NiceCircuits/DrOctopus/design/mechanical/sketches/_MG_1017.JPG

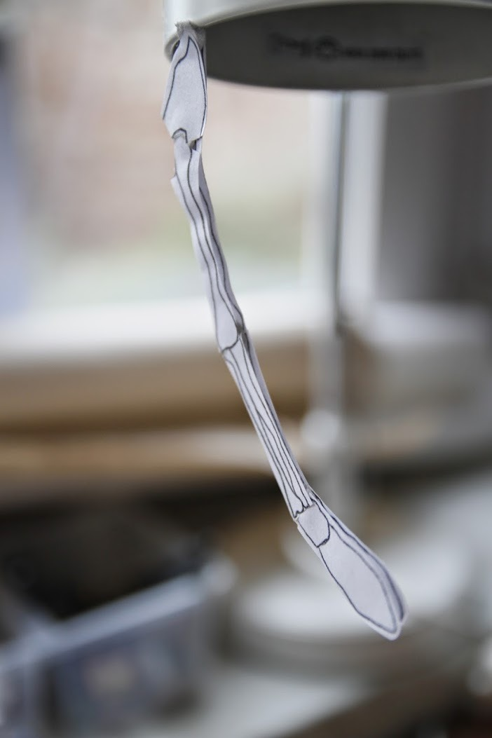
design/mechanical/sketches/_MG_1017.JPG
