NiceCircuits/DrOctopus/design/mechanical/sketches/_MG_1016.JPG

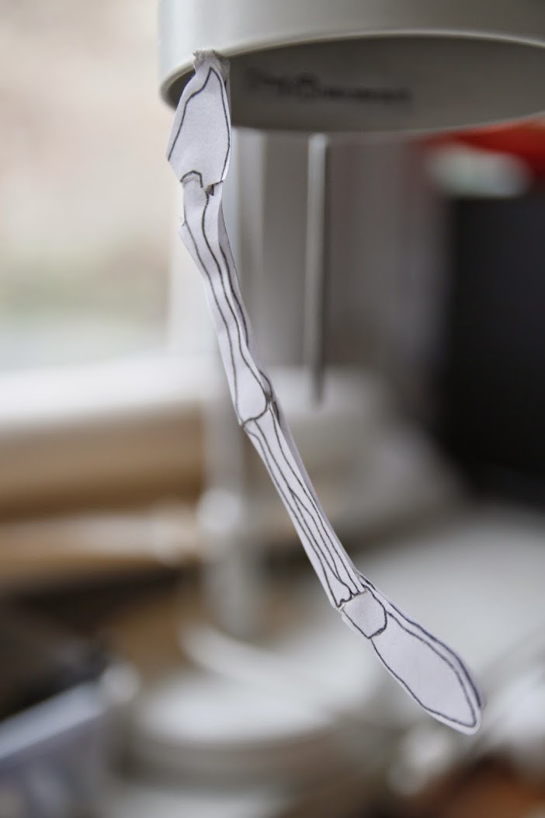
design/mechanical/sketches/_MG_1016.JPG
