NiceCircuits/DrOctopus/design/calculations.xls

Sheet: uC pinout
HW0 - STM32F303RE |  |  |  |  |  |  |  |  |  | HW1 - STM32F030RCT |  |  |  |  |  |  |  |  |  | HW1 - STM32F103RE - discarded
pin | pin type | main function | ADC | PWM1 | PWM2 | UART | I2C | Other | Function | pin | pin type | main function | ADC | PWM1 | PWM2 | UART | I2C | Other | Function | pin | pin type | main function | ADC | PWM1 | PWM2 | UART | I2C | Other | Function
1 | pwrIn | VBAT |  |  |  |  |  |  | - | 1 | pwrIn | VDD |  |  |  |  |  |  | - | 1 | pwrIn | VBAT |  |  |  |  |  |  | -
2 | IO | PC13-TAMPER-RTC |  |  | TIM1_CH1N |  |  |  | N.C. | 2 | IO | PC13-TAMPER-RTC |  |  |  |  |  |  | N.C. | 2 | IO | PC13-TAMPER-RTC |  |  |  |  |  |  | N.C.
3 | IO | PC14-OSC32_IN |  |  |  |  |  |  | N.C. | 3 | IO | PC14-OSC32_IN |  |  |  |  |  |  | N.C. | 3 | IO | PC14-OSC32_IN |  |  |  |  |  |  | N.C.
4 | IO | PC15-OSC32_OUT |  |  |  |  |  |  | N.C. | 4 | IO | PC15-OSC32_OUT |  |  |  |  |  |  | N.C. | 4 | IO | PC15-OSC32_OUT |  |  |  |  |  |  | N.C.
5 | IO | OSC_IN |  |  | TIM1_CH3N |  | I2C2_SDA | PF0 | - | 5 | input | OSC_IN |  |  |  |  |  |  | - | 5 | input | OSC_IN |  |  |  |  |  |  | -
6 | IO | OSC_OUT |  |  |  |  | I2C2_SCL | PF1 | - | 6 | output | OSC_OUT |  |  |  |  |  |  | - | 6 | output | OSC_OUT |  |  |  |  |  |  | -
7 | IO | NRST |  |  |  |  |  |  | - | 7 | IO | NRST |  |  |  |  |  |  | - | 7 | IO | NRST |  |  |  |  |  |  | -
8 | IO | PC0 | ADC12_IN6 | TIM1_CH1 |  |  |  |  | heater_sig | 8 | IO | PC0 | ADC_IN10 |  |  | USART6_TX USART7_TX |  |  | N.C. | 8 | IO | PC0 | ADC12_IN10 |  |  |  |  |  | N.C.
9 | IO | PC1 | ADC12_IN7 | TIM1_CH2 |  |  |  |  | therm3_sig | 9 | IO | PC1 | ADC_IN11 |  |  | USART6_RX USART7_RX |  |  | therm3_sig | 9 | IO | PC1 | ADC12_IN11 |  |  |  |  |  | therm3_sig
10 | IO | PC2 | ADC12_IN8 | TIM1_CH3 |  |  |  |  | therm4_sig | 10 | IO | PC2 | ADC_IN12 |  |  |  |  |  | therm4_sig | 10 | IO | PC2 | ADC12_IN12 |  |  |  |  |  | therm4_sig
11 | IO | PC3 | ADC12_IN9 | TIM1_CH4 |  |  |  |  | therm1_sig | 11 | IO | PC3 | ADC_IN13 |  |  |  |  |  | therm5_sig | 11 | IO | PC3 | ADC12_IN13 |  |  |  |  |  | therm5_sig
12 | pwrIn | VSSA |  |  |  |  |  |  | - | 12 | pwrIn | VSSA |  |  |  |  |  |  | - | 12 | pwrIn | VSSA |  |  |  |  |  |  | -
13 | pwrIn | VDDA |  |  |  |  |  |  | - | 13 | pwrIn | VDDA |  |  |  |  |  |  | - | 13 | pwrIn | VDDA |  |  |  |  |  |  | -
14 | IO | PA0/WKUP | ADC1_IN1 | TIM2_CH1 |  |  |  |  | therm2_sig | 14 | IO | PA0/WKUP | ADC_IN0 |  |  | USART4_TX |  |  | N.C. | 14 | IO | PA0/WKUP | ADC12_IN0 | TIM2_CH1 |  |  |  |  | N.C.
15 | IO | PA1 | ADC1_IN2 | TIM2_CH2 | TIM15_CH1N |  |  |  | bts_fb_sig | 15 | IO | PA1 | ADC_IN1 |  |  | USART4_RX |  |  | N.C. | 15 | IO | PA1 | ADC12_IN1 | TIM2_CH2 |  |  |  |  | N.C.
16 | IO | PA2 | ADC1_IN3 | TIM2_CH3 | TIM15_CH1 | USART2_TX |  |  | DBG_TxD | 16 | IO | PA2 | ADC_IN2 | TIM15_CH1 |  | USART2_TX |  |  | DBG_TxD | 16 | IO | PA2 | ADC12_IN2 | TIM2_CH3 |  | USART2_TX |  |  | DBG_TxD
17 | IO | PA3 | ADC1_IN4 | TIM2_CH4 | TIM15_CH2 | USART2_RX |  |  | DBG_RxD | 17 | IO | PA3 | ADC_IN3 | TIM15_CH2 |  | USART2_RX |  |  | DBG_RxD | 17 | IO | PA3 | ADC12_IN3 | TIM2_CH4 |  | USART2_RX |  |  | DBG_RxD
18 | pwrIn | VSS |  |  |  |  |  |  | - | 18 | pwrIn | VSS |  |  |  |  |  |  | - | 18 | pwrIn | VSS |  |  |  |  |  |  | -
19 | pwrIn | VDD |  |  |  |  |  |  | - | 19 | pwrIn | VDD |  |  |  |  |  |  | - | 19 | pwrIn | VDD |  |  |  |  |  |  | -
20 | IO | PA4 | ADC2_IN1 | TIM3_CH2 |  |  |  |  |  | 20 | IO | PA4 | ADC_IN4 | TIM14_CH1 |  | USART6_TX |  |  | B2B_therm6_sig | 20 | IO | PA4 | ADC12_IN4 |  |  |  |  |  | B2B_therm6_sig
21 | IO | PA5 | ADC2_IN2 | TIM2_CH1 |  |  |  |  | led1_cmd | 21 | IO | PA5 | ADC_IN5 |  |  | USART6_RX |  |  | heater_sig | 21 | IO | PA5 | ADC12_IN5 |  |  |  |  |  | heater_sig
22 | IO | PA6 | ADC2_IN3 | TIM3_CH1 | TIM16_CH1 |  |  |  |  | 22 | IO | PA6 | ADC_IN6 | TIM3_CH1 | TIM16_CH1 |  |  |  | therm0_sig | 22 | IO | PA6 | ADC12_IN6 | TIM3_CH1 |  |  |  |  | therm0_sig
23 | IO | PA7 | ADC2_IN4 | TIM3_CH2 | TIM1_CH1N,... |  |  |  |  | 23 | IO | PA7 | ADC_IN7 | TIM3_CH2 | TIM1_CH1N TIM14_CH1 TIM17_CH1 |  |  |  | therm1_sig | 23 | IO | PA7 | ADC12_IN7 | TIM3_CH2 | TIM1_CH1N |  |  |  | therm1_sig
24 | IO | PC4 | ADC2_IN5 |  |  | USART1_TX |  |  |  | 24 | IO | PC4 | ADC_IN14 |  |  | USART3_TX |  |  | therm2_sig | 24 | IO | PC4 | ADC12_IN14 |  |  |  |  |  | therm2_sig
25 | IO | PC5 | ADC2_IN11 |  |  | USART1_RX |  |  |  | 25 | IO | PC5 | ADC_IN15 |  |  | USART3_RX |  |  | bts_fb_sig | 25 | IO | PC5 | ADC12_IN15 |  |  |  |  |  | bts_fb_sig
26 | IO | PB0 | ADC3_IN12 | TIM3_CH3 | TIM1_CH2N,... |  |  |  | B2B_esp_boot | 26 | IO | PB0 | ADC_IN8 | TIM3_CH3 | TIM1_CH2N |  |  |  | B2B_esp_boot | 26 | IO | PB0 | ADC12_IN8 | TIM3_CH3 | TIM1_CH2N |  |  |  | B2B_esp_boot
27 | IO | PB1 | ADC3_IN1 | TIM3_CH4 | TIM1_CH3N,... |  |  |  | B2B_esp_en | 27 | IO | PB1 | ADC_IN9 | TIM3_CH4 | TIM1_CH3N TIM14_CH1 |  |  |  | B2B_esp_en | 27 | IO | PB1 | ADC12_IN9 | TIM3_CH4 | TIM1_CH3N |  |  |  | B2B_esp_en
28 | IO | PB2 | ADC2_IN12 |  |  |  |  |  | N.C. | 28 | IO | PB2 |  |  |  |  |  |  | N.C. | 28 | IO | PB2 |  |  |  |  |  |  | N.C.
29 | IO | PB10 |  | TIM2_CH3 |  | USART3_TX |  |  |  | 29 | IO | PB10 |  |  |  | USART3_TX | I2C2_SCL |  | scl | 29 | IO | PB10 |  | TIM2_CH3 |  | USART3_TX | I2C2_SCL |  | scl
30 | IO | PB11 | ADC12_IN14 | TIM2_CH4 |  | USART3_RX |  |  | therm0_sig | 30 | IO | PB11 |  |  |  | USART3_RX | I2C2_SDA |  | sda | 30 | IO | PB11 |  | TIM2_CH4 |  | USART3_RX | I2C2_SDA |  | sda
31 | pwrIn | VSS |  |  |  |  |  |  | - | 31 | pwrIn | VSS |  |  |  |  |  |  | - | 31 | pwrIn | VSS |  |  |  |  |  |  | -
32 | pwrIn | VDD |  |  |  |  |  |  | - | 32 | pwrIn | VDD |  |  |  |  |  |  | - | 32 | pwrIn | VDD |  |  |  |  |  |  | -
33 | IO | PB12 | ADC4_IN3 |  |  |  |  |  |  | 33 | IO | PB12 |  |  |  |  |  |  | led1_cmd | 33 | IO | PB12 |  |  |  |  |  |  | led1_cmd
34 | IO | PB13 | ADC3_IN5 |  | TIM1_CH1N |  |  |  | led2_cmd | 34 | IO | PB13 |  |  | TIM1_CH1N |  | I2C2_SDA |  | led2_cmd | 34 | IO | PB13 |  |  | TIM1_CH1N |  |  |  | led2_cmd
35 | IO | PB14 | ADC4_IN4 | TIM15_CH1 | TIM1_CH2N |  |  |  | led3_cmd | 35 | IO | PB14 |  | TIM15_CH1 | TIM1_CH2N |  | I2C2_SDA |  | servo6_cmd - alternative | 35 | IO | PB14 |  |  | TIM1_CH2N |  |  |  | N.C.
36 | IO | PB15 | ADC4_IN5 | TIM15_CH2 | TIM1_CH3N |  |  |  | N.C. | 36 | IO | PB15 |  | TIM15_CH2 | TIM1_CH3N |  |  |  | servo5_cmd - alternative | 36 | IO | PB15 |  |  | TIM1_CH3N |  |  |  | N.C.
37 | IO | PC6 |  | TIM3_CH1 | TIM8_CH1 |  |  |  | heater_cmd | 37 | IO | PC6 |  | TIM3_CH1 |  |  |  |  | heater_cmd | 37 | IO | PC6 |  | TIM3_CH1 |  |  |  |  | heater_cmd
38 | IO | PC7 |  | TIM3_CH2 | TIM8_CH2 |  |  |  | fan1_cmd | 38 | IO | PC7 |  | TIM3_CH2 |  |  |  |  | fan1_cmd | 38 | IO | PC7 |  | TIM3_CH2 |  |  |  |  | fan1_cmd
39 | IO | PC8 |  | TIM3_CH3 | TIM8_CH3 |  |  |  | fan2_cmd | 39 | IO | PC8 |  | TIM3_CH3 |  |  |  |  | fan2_cmd | 39 | IO | PC8 |  | TIM3_CH3 |  |  |  |  | fan2_cmd
40 | IO | PC9 |  | TIM3_CH4 | TIM8_CH4 |  | I2C3_SDA |  | motor_cmd | 40 | IO | PC9 |  | TIM3_CH4 |  |  |  |  | motor_cmd | 40 | IO | PC9 |  | TIM3_CH4 |  |  |  |  | motor_cmd
41 | IO | PA8 |  | TIM1_CH1 |  |  | I2C3_SCL |  | servo0_cmd | 41 | IO | PA8 |  | TIM1_CH1 |  |  |  |  | servo0_cmd | 41 | IO | PA8 |  | TIM1_CH1 |  |  |  |  | servo0_cmd
42 | IO | PA9 |  | TIM1_CH2 | TIM2_CH3 | USART1_TX | I2C2_SCL |  | servo1_cmd | 42 | IO | PA9 |  | TIM1_CH2 |  | USART1_TX | I2C1_SCL |  | servo1_cmd | 42 | IO | PA9 |  | TIM1_CH2 |  | USART1_TX |  |  | servo1_cmd
43 | IO | PA10 |  | TIM1_CH3 | TIM2_CH4 | USART1_RX | I2C2_SDA |  | servo2_cmd | 43 | IO | PA10 |  | TIM1_CH3 |  | USART1_RX | I2C1_SDA |  | servo2_cmd | 43 | IO | PA10 |  | TIM1_CH3 |  | USART1_RX |  |  | servo2_cmd
44 | IO | PA11 |  | TIM1_CH4 | TIM4_CH1 |  |  | USBDM | servo3_cmd | 44 | IO | PA11 |  | TIM1_CH4 |  |  | I2C2_SCL |  | servo3_cmd | 44 | IO | PA11 |  | TIM1_CH4 |  |  |  | USBDM | servo3_cmd
45 | IO | PA12 |  | TIM16_CH1 | TIM4_CH2 |  |  | USBDP | servo5_cmd | 45 | IO | PA12 |  |  |  |  | I2C2_SDA |  | N.C. | 45 | IO | PA12 |  |  |  |  |  | USBDP | N.C.
46 | IO | PA13/TMS |  | TIM16_CH1N | TIM4_CH3 |  |  | TMS | servo4_cmd | 46 | IO | PA13/TMS |  |  |  |  |  | TMS | SWDIO | 46 | IO | PA13/TMS |  |  |  |  |  | TMS | SWDIO
47 | pwrIn | VSS |  |  |  |  |  |  | - | 47 | pwrIn | VSS |  |  |  |  |  |  | - | 47 | pwrIn | VSS |  |  |  |  |  |  | -
48 | pwrIn | VDD |  |  |  |  |  |  | - | 48 | pwrIn | VDD |  |  |  |  |  |  | - | 48 | pwrIn | VDD |  |  |  |  |  |  | -
49 | IO | PA14/TCK |  |  | TIM8_CH1 | USART2_TX | I2C1_SDA | TCK | SWCLK | 49 | IO | PA14/TCK |  |  |  | USART2_TX |  | TCK | SWCLK | 49 | IO | PA14/TCK |  |  |  |  |  | TCK | WCLK
50 | IO | PA15 |  | TIM2_CH1 | TIM8_CH2 | USART2_RX | I2C1_SCL |  | button0_sig | 50 | IO | PA15 |  |  |  | USART2_RX |  |  | button0_sig | 50 | IO | PA15 |  | TIM2_CH1 |  |  |  |  | button0_sig
51 | IO | PC10 |  |  | TIM8_CH1N | USART3_TX |  |  | B2B_ESP_TxD | 51 | IO | PC10 |  |  |  | USART3_TX USART4_TX |  |  | B2B_ESP_TxD | 51 | IO | PC10 |  |  |  | USART3_TX |  |  | B2B_ESP_TxD
52 | IO | PC11 |  |  | TIM8_CH2N | USART3_RX |  |  | B2B_ESP_RxD | 52 | IO | PC11 |  |  |  | USART3_RX USART4_RX |  |  | B2B_ESP_RxD | 52 | IO | PC11 |  |  |  | USART3_RX |  |  | B2B_ESP_RxD
53 | IO | PC12 |  |  | TIM8_CH3N | UART5_TX |  |  | button1_sig | 53 | IO | PC12 |  |  |  | USART5_TX |  |  | button1_sig | 53 | IO | PC12 |  |  |  |  |  |  | button1_sig
54 | IO | PD2 |  |  |  |  | UART5_RX |  | N.C. | 54 | IO | PD2 |  |  |  | USART5_RX |  |  | N.C. | 54 | IO | PD2 |  |  |  |  |  |  | N.C.
55 | IO | PB3/SWO |  | TIM2_CH2 | TIM8_CH1N | USART2_TX |  | SWO | SWO | 55 | IO | PB3/SWO |  |  |  | USART5_TX |  |  | SWO not available | 55 | IO | PB3/SWO |  | TIM2_CH2 |  |  |  | SWO | SWO
56 | IO | PB4 |  | TIM3_CH1 | TIM8_CH2N | USART2_RX |  |  | N.C. | 56 | IO | PB4 |  | TIM3_CH1 |  | USART5_RX |  |  | N.C. | 56 | IO | PB4 |  | TIM3_CH1 |  |  |  |  | N.C.
57 | IO | PB5 |  | TIM3_CH2 | TIM8_CH3N |  | I2C3_SDA |  | N.C. | 57 | IO | PB5 |  | TIM3_CH2 |  |  |  |  | N.C. | 57 | IO | PB5 |  | TIM3_CH2 |  |  |  |  | N.C.
58 | IO | PB6 |  | TIM4_CH1 | TIM8_CH1 | USART1_TX | I2C1_SCL |  | servo6_cmd | 58 | IO | PB6 |  | TIM16_CH1N |  | USART1_TX | I2C1_SCL |  | servo6_cmd - no pwm! | 58 | IO | PB6 |  | TIM4_CH1 |  | USART1_TX | I2C1_SCL |  | servo6_cmd
59 | IO | PB7 |  | TIM4_CH2 | TIM3_CH4 | USART1_RX | I2C1_SDA |  | sda | 59 | IO | PB7 |  | TIM17_CH1N |  | USART1_RX | I2C1_SDA |  | servo5_cmd - no pwm! | 59 | IO | PB7 |  | TIM4_CH2 |  | USART1_RX | I2C1_SDA |  | servo5_cmd
60 | input | BOOT0 |  |  |  |  |  |  | - | 60 | input | BOOT0 |  |  |  |  |  |  | - | 60 | input | BOOT0 |  |  |  |  |  |  | -
61 | IO | PB8 |  | TIM4_CH3 | TIM8_CH2 | USART3_RX | I2C1_SCL |  | scl | 61 | IO | PB8 |  | TIM16_CH1 |  |  | I2C1_SCL |  | servo4_cmd | 61 | IO | PB8 |  | TIM4_CH3 |  |  | I2C1_SCL |  | servo4_cmd
62 | IO | PB9 |  | TIM4_CH4 | TIM8_CH3 | USART3_TX | I2C1_SDA |  | servo7_cmd | 62 | IO | PB9 |  | TIM17_CH1 |  |  | I2C1_SDA |  | servo7_cmd | 62 | IO | PB9 |  | TIM4_CH4 |  |  | I2C1_SDA |  | servo7_cmd
63 | pwrIn | VSS |  |  |  |  |  |  | - | 63 | pwrIn | VSS |  |  |  |  |  |  | - | 63 | pwrIn | VSS |  |  |  |  |  |  | -
64 | pwrIn | VDD |  |  |  |  |  |  | - | 64 | pwrIn | VDD |  |  |  |  |  |  | - | 64 | pwrIn | VDD |  |  |  |  |  |  | -
 |  | needed | 9 | 4..12 |  | 4 | 2 |  | N.C.
 |  |  |  |  |  |  |  |  | N.C.
 |  |  |  |  |  |  |  |  | N.C.
 |  |  |  |  |  |  |  |  | B2B_therm6_sig
 |  |  |  |  |  |  |  |  | therm5_sig

Sheet: uC peripherals
HW0 - STM32F303RE
Timers
Timer | Used as
TIM1 | Servos
TIM2 | Delay
TIM3 | PWM
TIM4 | Servos
TIM6
TIM7
TIM8
TIM15
TIM16
TIM17
TIM20
UARTs
USART1
USART2 | Debug
USART3 | ESP8266
UART4
UART5
