NiceCircuits/DrOctopus/design/mechanical/design.xls

DrOctopus arm design
Motors |  |  |  | g [m/s2] | 10
 | mass [kg] | max. acceleration [deg/s2]
M0 | 0.1 | 50
M1 | 0.2 | 50
M2 | 0.1 | 50
M3 | 0.05 | 50
arm segments
 | mass [kg] | length [m]
l1 | 0.3 | 0.3
l2 | 0.3 | 0.24
l3 | 0.1 | 0.1
mass of actuator [kg]
A | 0.3
Absolute maximum moments on joints (motors)
 | static [N*m] | dynamic [N*m] | static+dynamic
 |  |  | [N*m] | [kg*cm]
M0 | 0 | 0.31 | 0.31 | 3.1
M1 | 3.45 | 0.31 | 3.76 | 37.6
M2 | 1.2 | 0.13 | 1.33 | 13.3
M3 | 0 | 0.03 | 0.03 | 0.3
Real values
a,b max=90*
a,b min=0*
 | static [N*m] | dynamic [N*m] | static+dynamic
 |  |  | [N*m] | [kg*cm]
M0 | 0 | 0.31 | 0.31 | 3.1
M1 | 2.7 | 0.31 | 3.01 | 30.1
M2 | 1.2 | 0.13 | 1.33 | 13.3
M3 | 0 | 0.03 | 0.03 | 0.3
