NiceCircuits/DrOctopus/3D model/plywood_6mm.pdf

P

R

O
D

U

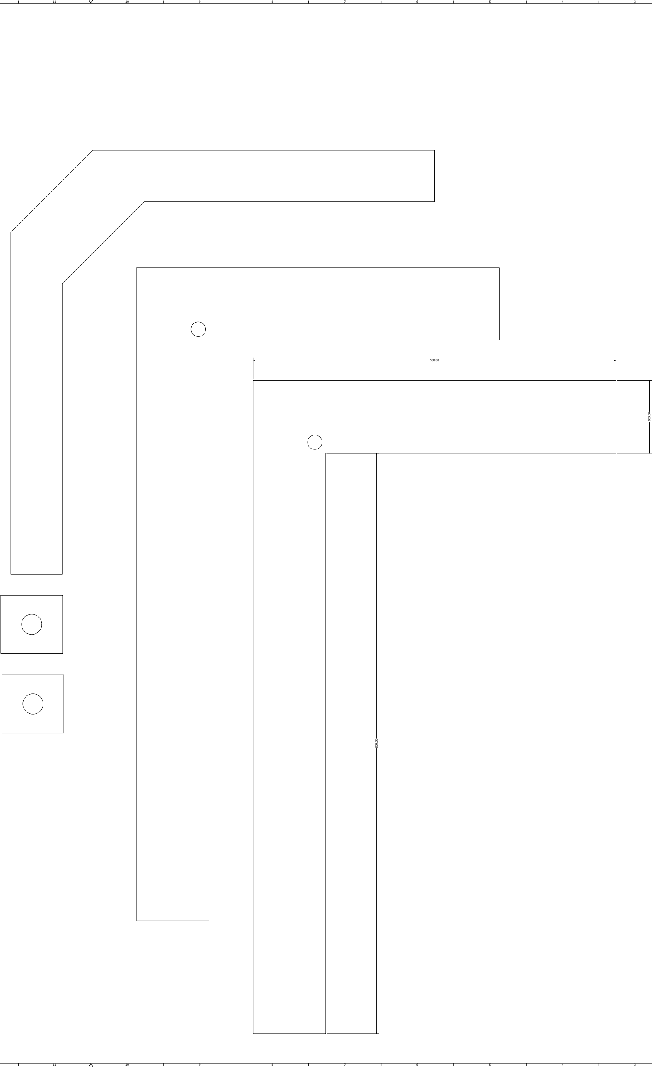
[picture p3: figure]

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
# TIO

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
# TIO

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
# PRODUCED BY AN AUTODESK EDUCATIONAL PRODUCT

# PRODUCED BY AN AUTODESK EDUCATIONAL PRODUCT

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
## ply

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
600.00
