NiceCircuits/DrOctopus/3D model/full_instalation.jpg

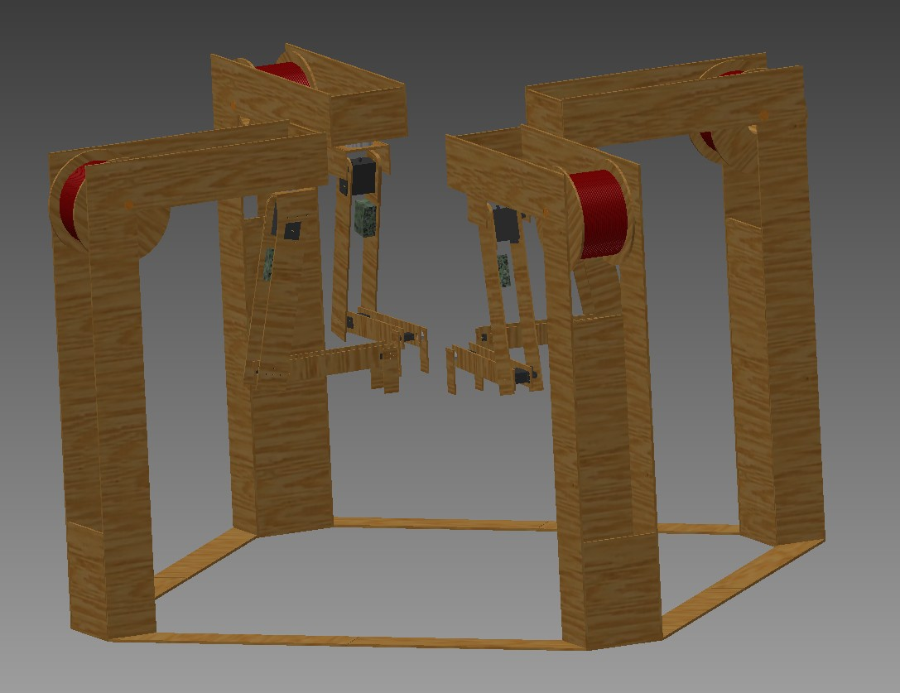
3D model/full_instalation.jpg
