NiceCircuits/DrOctopus/design/mechanical/sketches/2014-07-31 18.15.07.jpg

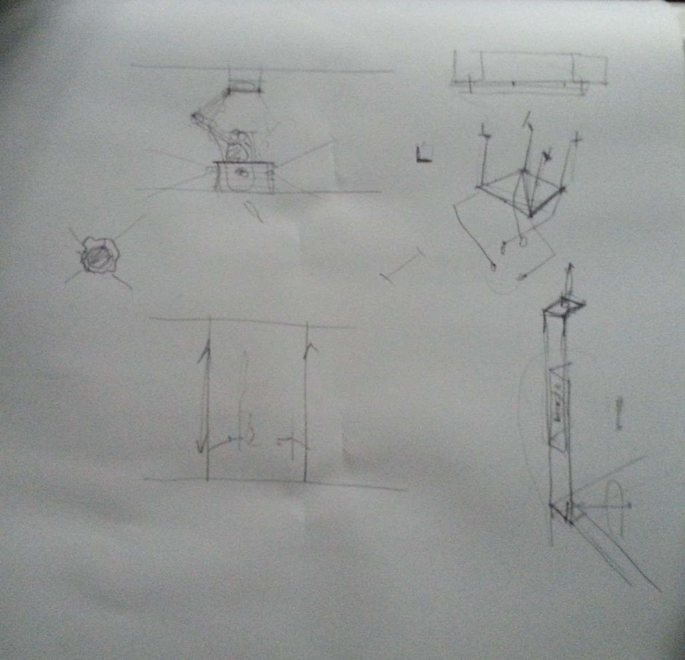
design/mechanical/sketches/2014-07-31 18.15.07.jpg
