NiceCircuits/DrOctopus/design/mechanical/sketches/_MG_1014.JPG

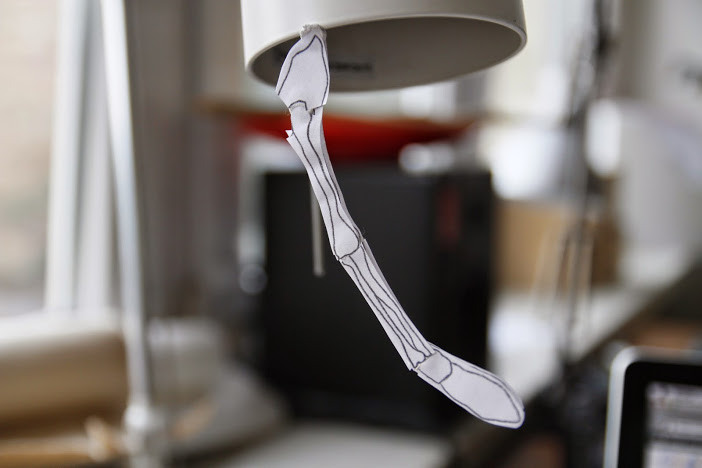
design/mechanical/sketches/_MG_1014.JPG
