NiceCircuits/DrOctopus/design/mechanical/sketches/_MG_1015.JPG

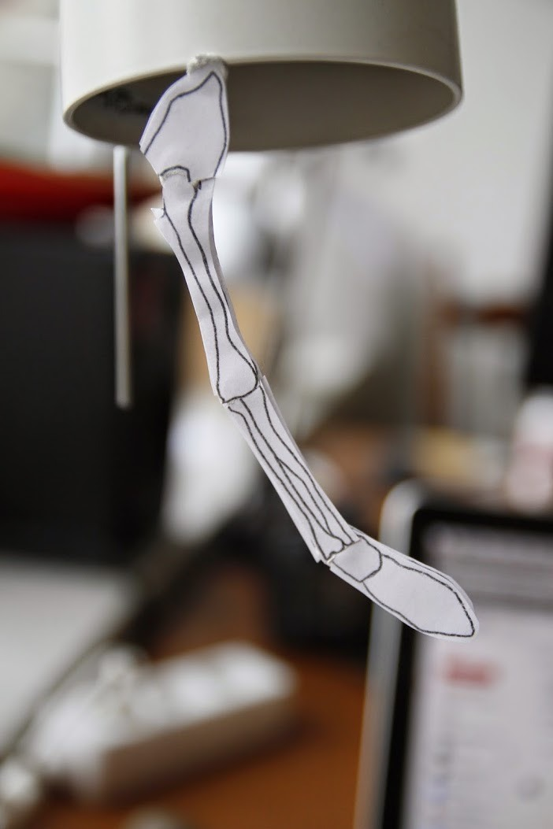
design/mechanical/sketches/_MG_1015.JPG
