NiceCircuits/DrOctopus/design/mechanical/sketches/_MG_1018.JPG

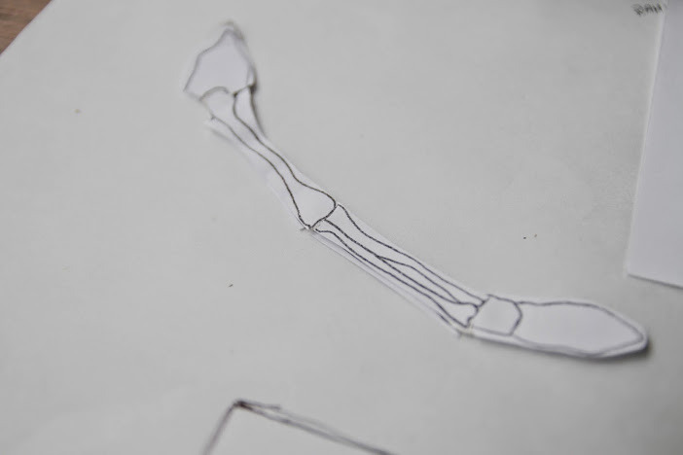
design/mechanical/sketches/_MG_1018.JPG
