NiceCircuits/DrOctopus/design/mechanical/sketches/Oficyna_instalacja_1.jpg

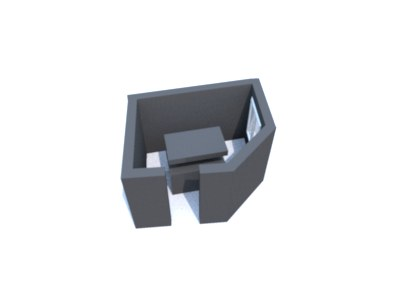
design/mechanical/sketches/Oficyna_instalacja_1.jpg
