NiceCircuits/DrOctopus/design/mechanical/sketches/Oficyna_instalacja_2.jpg

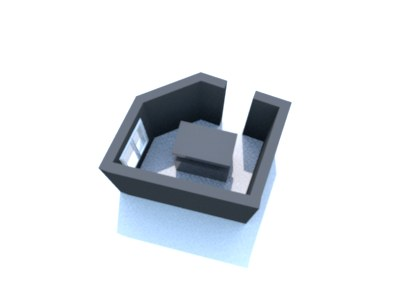
design/mechanical/sketches/Oficyna_instalacja_2.jpg
