NiceCircuits/DrOctopus/design/mechanical/sketches/Szkic_instalacja_01.jpg

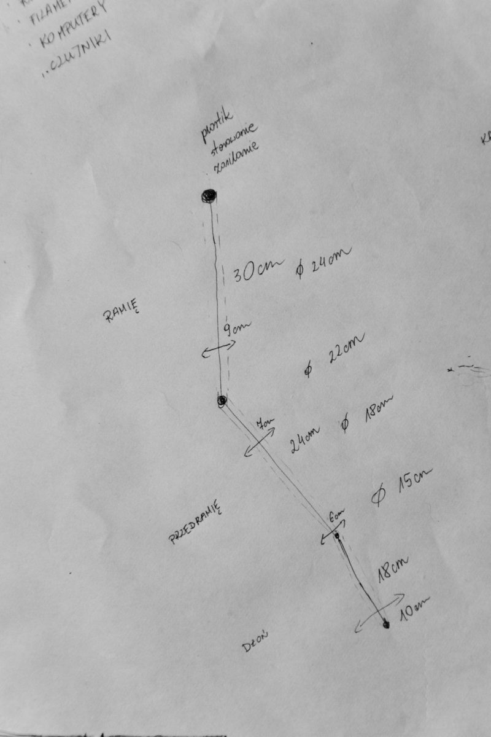
design/mechanical/sketches/Szkic_instalacja_01.jpg
