NiceCircuits/DrOctopus/design/mechanical/sketches/Szkic_instalacja_02.jpg

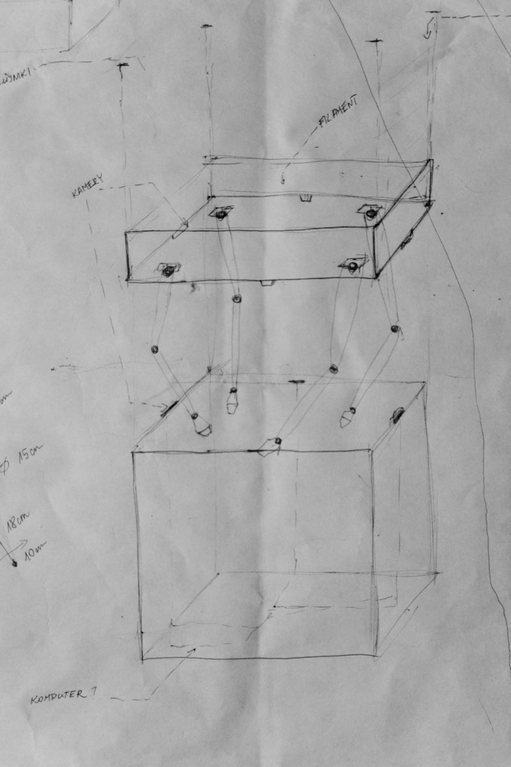
design/mechanical/sketches/Szkic_instalacja_02.jpg
