NiceCircuits/DrOctopus/design/mechanical/sketches/Szkic_instalacja_05.jpg

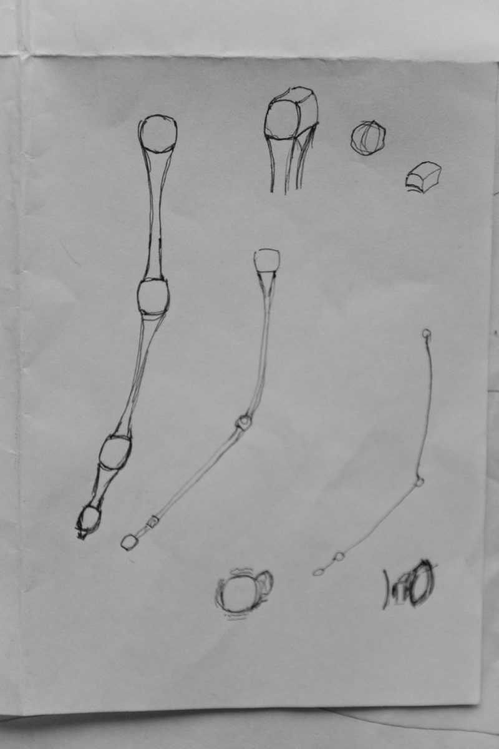
design/mechanical/sketches/Szkic_instalacja_05.jpg
