NiceCircuits/DrOctopus/pcb/DrOctopus2.0_BOM.xls

Part | Qty | Qty*4
100n 0603_N | 17 | 68 | 1
100R 4x0603_N | 1 | 4 | 1
100u/25V Cpol_6.3_11.0_HR_N ED1E101MNN6311U | 1 | 4 | 1
10k 0603_R_N | 4 | 16 | 1
10k 4x0603_N | 5 | 20 | 1
10k NTC 0603_N | 1 | 4 | 1
10u/16V 0805_N | 2 | 8 | 1
1k 0603_R_N | 3 | 12 | 1
1k 4x0603_N | 2 | 8 | 1
22u/6V3 Tantal_A_N T491A226K006AT | 2 | 8 | 1
2k2 0603_R_N | 1 | 4 | 1
470u/16V Cpol_8.0_12.0_HR_N ED1C471MNN0812 | 2 | 8 | 1
AMS1117-3.3 SOT223_N | 2 | 8 | 1
BAS40-05(DIOTEC) SOT23-3_N | 2 | 8 | bat54c
BEC EDG-5.08mm-4_N | 1 | 4 | 1
BTS142D D-PAK_N | 1 | 4 | 1
Button MicroswitchSmd6x4_N | 2 | 8 | 1
Ceramic_3.7x3.1_8Mhz 3.7x3.1_N | 1 | 4 | 1
DcDcDsun3A DcDcDsun3A_5.08N | 1 | 4 | 1
EDG-5.08mm-2_N | 2 | 8 | 1
ESP-07 ESP-07_N | 1 | 4
IRLML6244TRPBF SOT23-3_N | 3 | 12 | 1
LED 0805_N | 2 | 8 | 1
nut nut_M3_DIN985 | 8 | 32 | 1
nut_M2_DIN439 nut_M2_DIN439 | 1 | 4 | 1
Oled128x64_M Oled128x64_M_5.08N | 1 | 4 | 1
PESD5V2S2UT SOT23-3_N | 4 | 16 | 1
R 0603_R_N | 1 | 4 | 1
Reset MicroswitchSmd6x4_N | 1 | 4 | 1
screw_M2x10_DIN7985 screw_M2x10_DIN7985 | 1 | 4 | 1
spacer_2x5_plastic spacer_2x5_plastic | 1 | 4 | 1
spacer_M3x5+6 spacer_M3x5+6 | 8 | 32 | 1
SS14 SMA_N | 1 | 4 | 1
STM32F103RBT6 QFP-64-0.5_N | 1 | 4 | 1
