NiceCircuits/DrOctopus/3D model/arm_bom.xls

Item | Part Number | Thumbnail | BOM Structure | Unit QTY | QTY | Stock Number | Description | REV
16 | base_plate | (NonDisplayable) | Normal | 1 | 1
18 | Bearing 6006 ZZ - 30x55x13mm | (NonDisplayable) | Normal | 1 | 1
6 | Bearing 699ZZ - 9x20x6mm | (NonDisplayable) | Normal | 1 | 3
12 | segment0a | (NonDisplayable) | Normal | 1 | 2
13 | segment0b | (NonDisplayable) | Normal | 1 | 1
1 | segment1a | (NonDisplayable) | Normal | 1 | 1
4 | segment1b | (NonDisplayable) | Normal | 1 | 1
5 | segment1c | (NonDisplayable) | Normal | 1 | 1
8 | segment2a | (NonDisplayable) | Normal | 1 | 1
10 | segment2b | (NonDisplayable) | Normal | 1 | 1
15 | segment3a | (NonDisplayable) | Normal | 1 | 2
7 | servo 13kg BMS-630MG | (NonDisplayable) | Normal | 1 | 1
2 | servo 33kg TGY-S8166M | (NonDisplayable) | Normal | 1 | 1
3 | servo arm BMS-630MG tripple | (NonDisplayable) | Normal | 1 | 1
14 | servo arm DS939HV round | (NonDisplayable) | Normal | 1 | 1
11 | servo arm TGY-S8166M double | (NonDisplayable) | Normal | 1 | 1
9 | serwo 2.8kg DS939HV | (NonDisplayable) | Normal | 1 | 1
17 | Thrust Bearing 51106 - 30x47x11mm | (NonDisplayable) | Normal | 1 | 1
