NiceCircuits/DrOctopus/design/mechanical/BOM.xls

Part | Link | Qty | Comment
Standard 15kg servo | http://www.hobbyking.com/hobbyking/store/__46544__BMS_630MG_Super_Strong_Servo_13kg_17sec_49g_EU_Warehouse_.html | 2 | Elbow joint, shoulder Z joint
Medium 3kg servo | http://www.hobbyking.com/hobbyking/store/__44592__Corona_DS939HV_Digital_Metal_Gear_Servo_2_8kg_12_5g_0_12sec_EU_warehouse_.html | 1 | Wrist joint
Jumbo 30kg servo | http://www.hobbyking.com/hobbyking/store/__41740__Turnigy_S8166M_Servo_154g_33kg_21sec_EU_warehouse_.html | 1 | Shoulder joint
Standard 4kg servo | http://www.hobbyking.com/hobbyking/store/__39345__TGY_S4505B_40g_4_8kg_0_10sec_Dual_Bearing_Analog_Servo_EU_warehouse_.html | 1 | Extruder drive
Hotend |  | 1
Drive gear | http://reprap.me/extruder/mk7.html | 1
Fan |  | 1 | Hotend cooler
30cm servo ext. cable |  | 2
60cm servo ext. cable |  | 1
90cm servo ext. cable |  | 2
