NiceCircuits/DrOctopus/3D model/full_instalation.stp

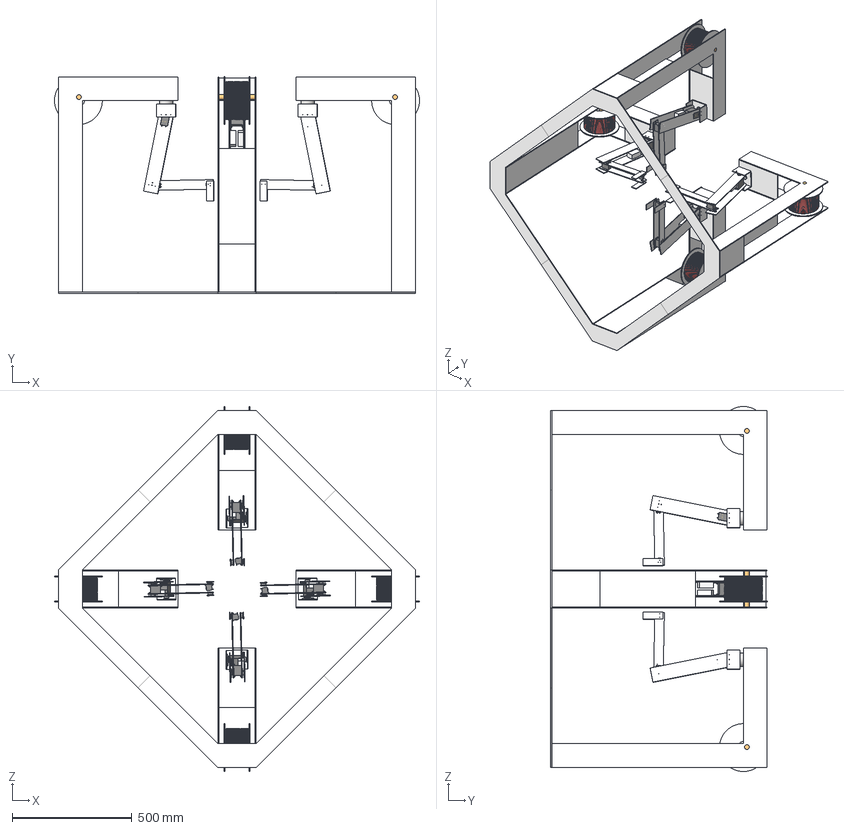
[picture p14: CAD file, 2014-10-20]
3D model/full_instalation.stp
1525.7 x 905.0 x 1525.7 mm
stand_plate1 x 8
stand_plate3 x 4
stand_plate4 x 4
base_plate x 4
Bearing 6006 ZZ - 30x55x13mm x 4
Thrust Bearing 51106 - 30x47x11mm x 4
pin x 4
stand_plate2 x 4
leg x 4
segment1a x 4
servo 33kg TGY-S8166M x 4
servo arm BMS-630MG tripple x 4
segment1b x 4
segment1c x 4
Bearing 699ZZ - 9x20x6mm x 12
servo 13kg BMS-630MG x 4
segment2a x 4
serwo 2.8kg DS939HV x 4
segment2b x 4
servo arm TGY-S8166M double x 4
segment0a x 8
segment0b x 4
servo arm DS939HV round x 4
segment3a x 8
elektronika x 4
filament x 4
roll x 4
