NiceCircuits/DrOctopus/3D model/3d_printing/plate2.stl

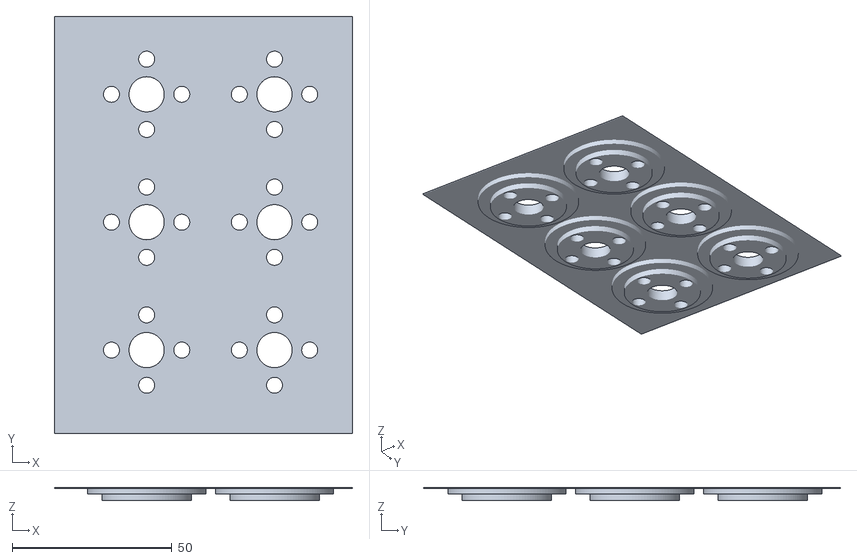
[picture p15: CAD file, 2014-11-03]
3D model/3d_printing/plate2.stl
93.2 x 130.5 x 4.00
