NiceCircuits/DrOctopus/3D model/arm/segment0_coupler1.stl

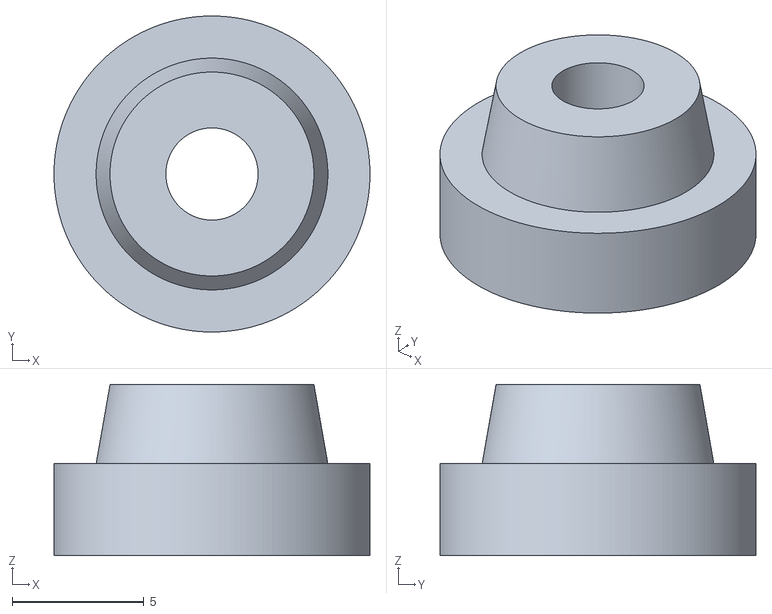
[picture p16: CAD file, 2014-11-03]
3D model/arm/segment0_coupler1.stl
12.0 x 12.0 x 6.50
