NiceCircuits/DrOctopus/3D model/stand/stand_coupler1.stl

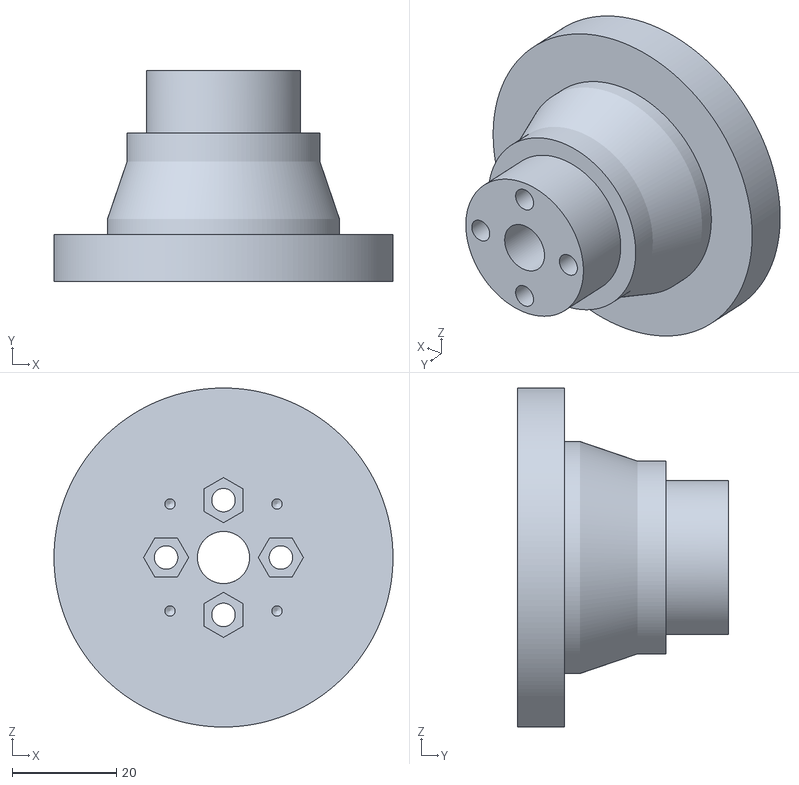
[picture p17: CAD file, 2014-11-03]
3D model/stand/stand_coupler1.stl
65.0 x 40.5 x 65.0
