NiceCircuits/DrOctopus/design/mechanical/working area.stp

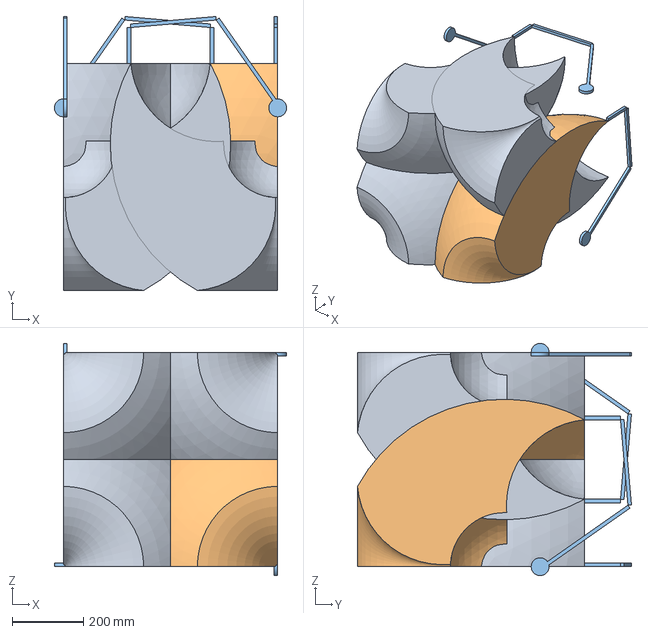
[picture p18: CAD file, 2014-10-09]
design/mechanical/working area.stp
650.0 x 766.9 x 650.0 mm
