NiceCircuits/DrOctopus/3D model/3d_printing/plate6.stl

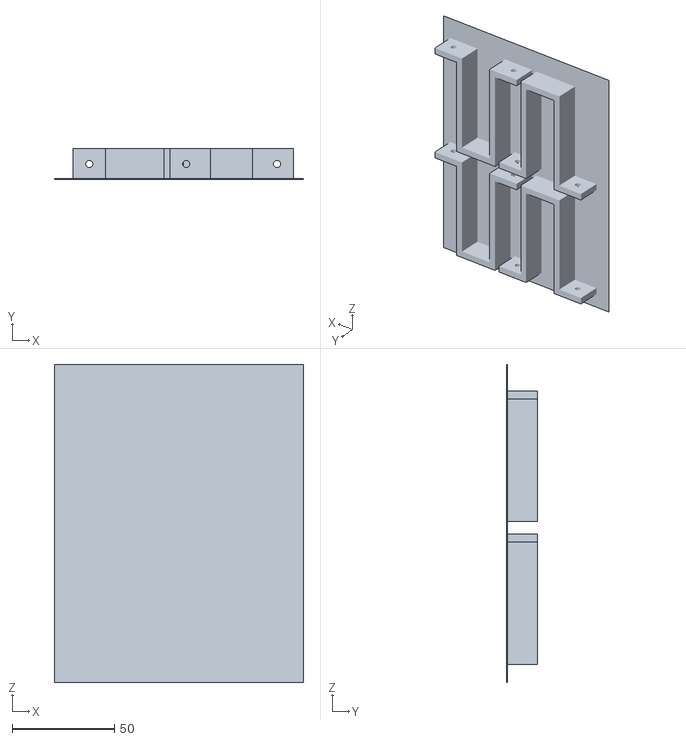
[picture p19: CAD file, 2014-11-03]
3D model/3d_printing/plate6.stl
122.1 x 15.0 x 155.8
