NiceCircuits/DrOctopus/3D model/arm/arm_coupler2.stl

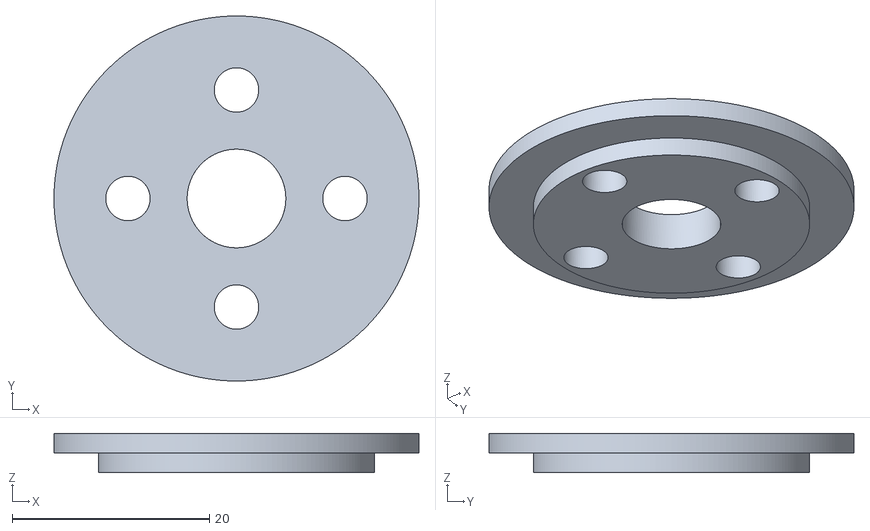
[picture p20: CAD file, 2014-11-03]
3D model/arm/arm_coupler2.stl
37.0 x 37.0 x 4.00
