NiceCircuits/DrOctopus/3D model/extruder/grip1.stl

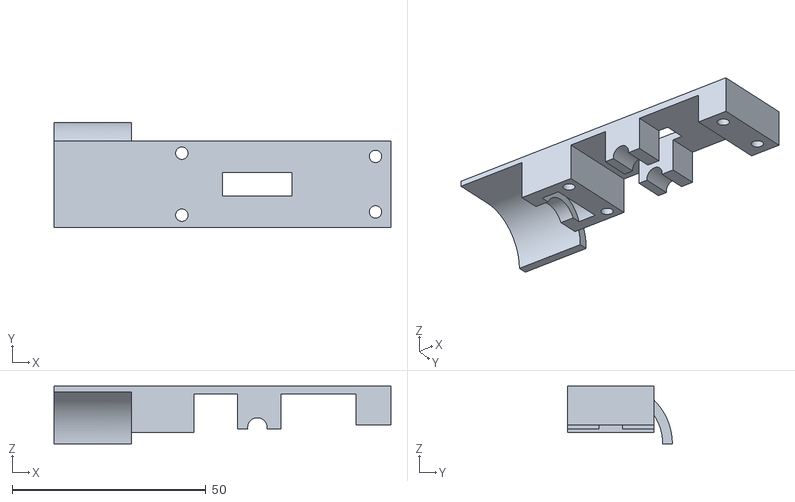
[picture p21: CAD file, 2015-09-28]
3D model/extruder/grip1.stl
87.0 x 27.0 x 14.9
