NiceCircuits/DrOctopus/3D model/3d_printing/plate5.stl

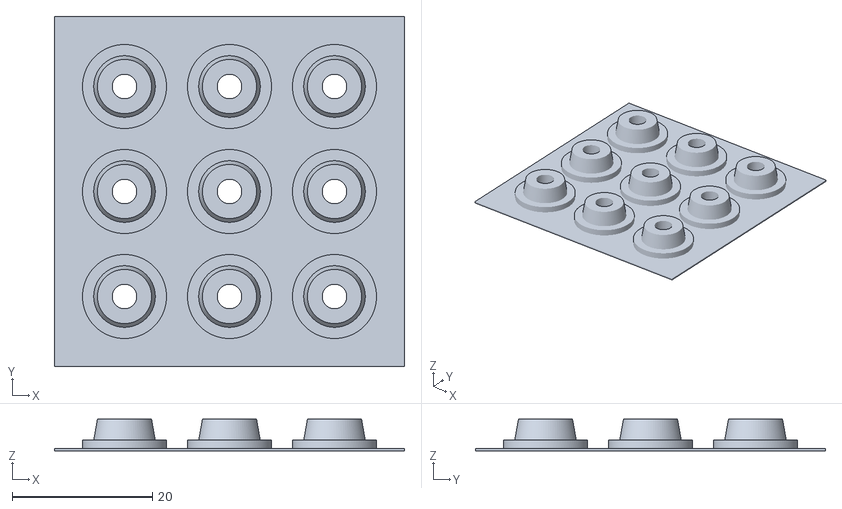
[picture p22: CAD file, 2014-11-03]
3D model/3d_printing/plate5.stl
50.0 x 50.0 x 4.50
