NiceCircuits/DrOctopus/3D model/arm/arm_drawing.dxf

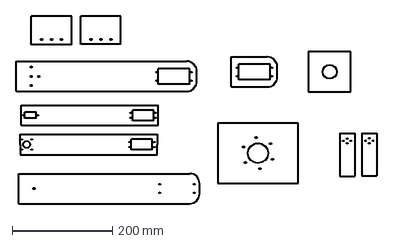
[picture p23: CAD file, 2014-10-12]
3D model/arm/arm_drawing.dxf
718.5 x 373.2 mm
