NiceCircuits/DrOctopus/3D model/clip.stl

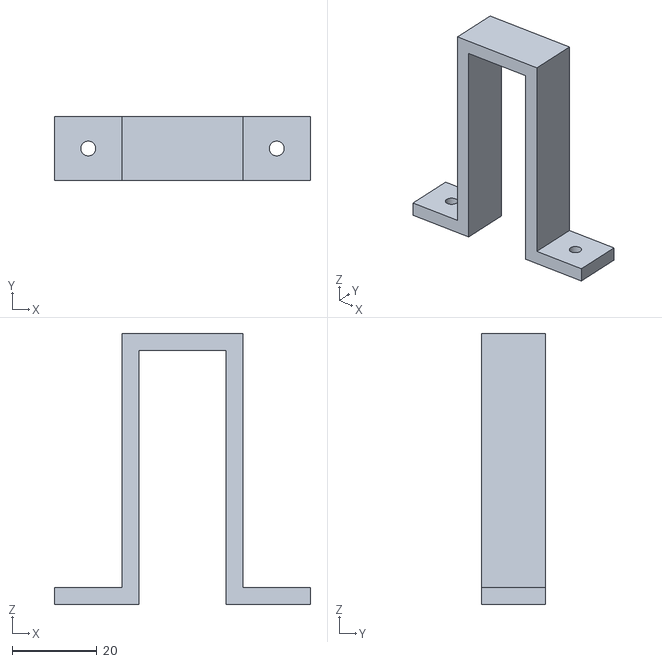
[picture p24: CAD file, 2014-11-03]
3D model/clip.stl
60.5 x 15.0 x 64.0
