NiceCircuits/DrOctopus/3D model/3d_printing/plate4.stl

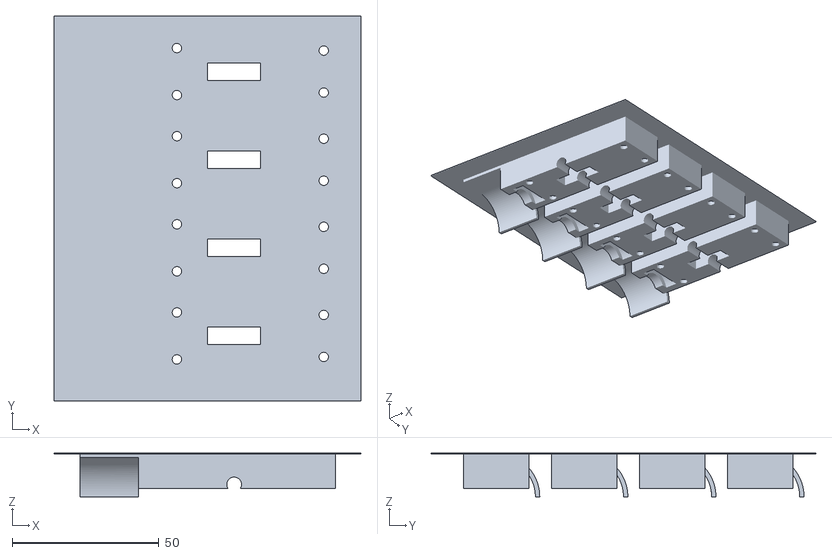
[picture p25: CAD file, 2014-11-03]
3D model/3d_printing/plate4.stl
104.5 x 131.1 x 14.9
