NiceCircuits/DrOctopus/3D model/extruder/grip.stl

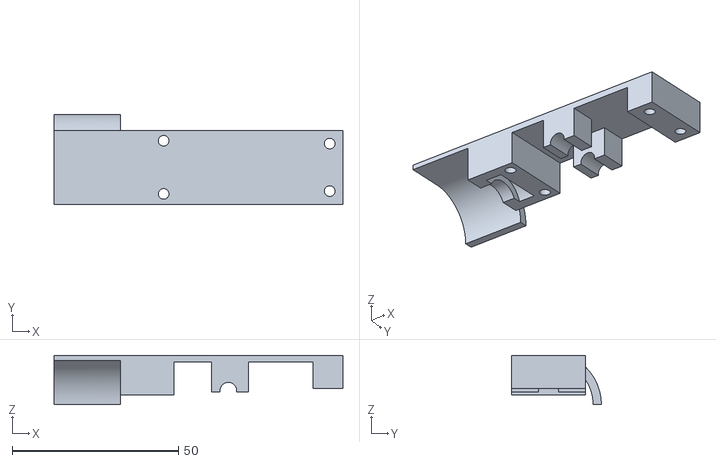
[picture p26: CAD file, 2015-09-28]
3D model/extruder/grip.stl
87.0 x 27.0 x 14.9
