NiceCircuits/DrOctopus/3D model/roll.dxf

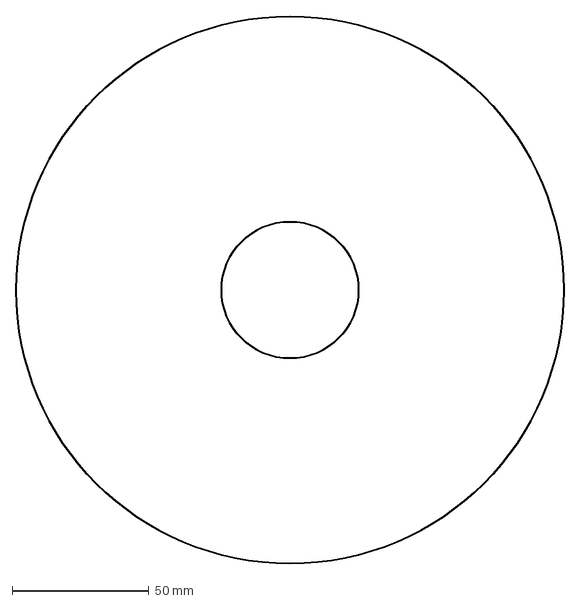
[picture p27: CAD file, 2014-10-21]
3D model/roll.dxf
200.0 x 200.0 mm
