NiceCircuits/DrOctopus/3D model/3d_printing/plate1_small.stl

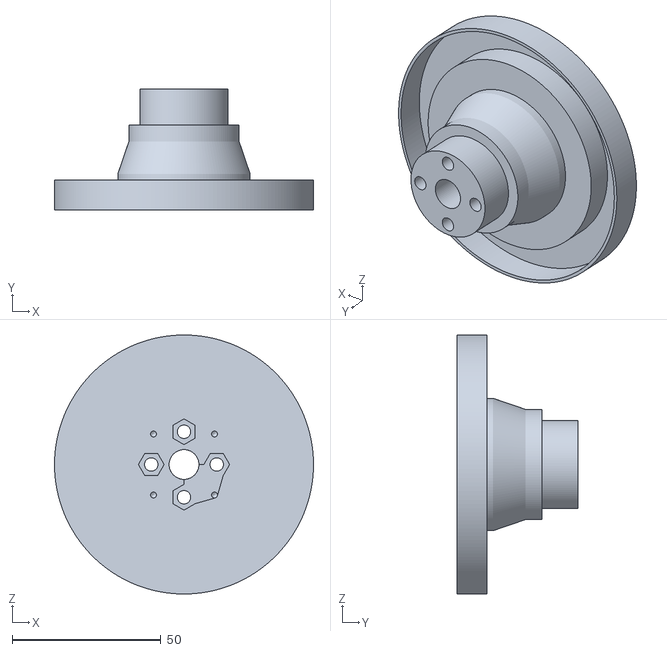
[picture p28: CAD file, 2014-11-03]
3D model/3d_printing/plate1_small.stl
87.0 x 40.5 x 87.0
