NiceCircuits/DrOctopus/3D model/extruder/body.stl

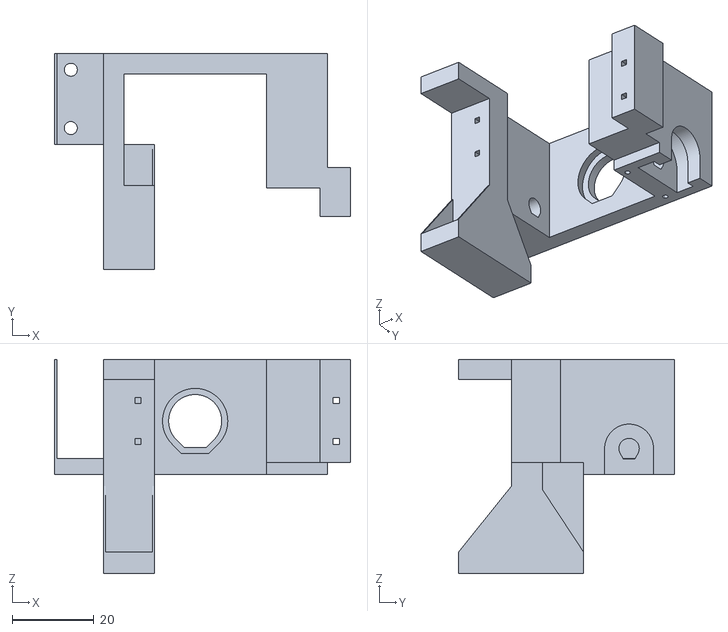
[picture p29: CAD file, 2014-11-03]
3D model/extruder/body.stl
72.6 x 53.0 x 52.6
