NiceCircuits/DrOctopus/3D model/3d_printing/plate1.stl

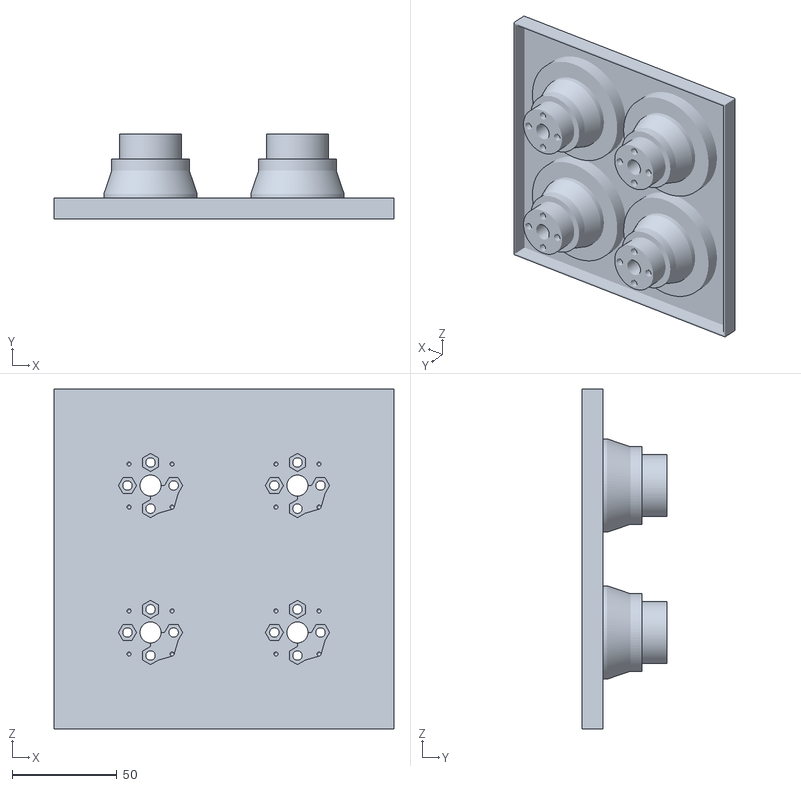
[picture p30: CAD file, 2014-11-03]
3D model/3d_printing/plate1.stl
162.0 x 40.5 x 162.0
