NiceCircuits/DrOctopus/3D model/3d_printing/plate3.stl

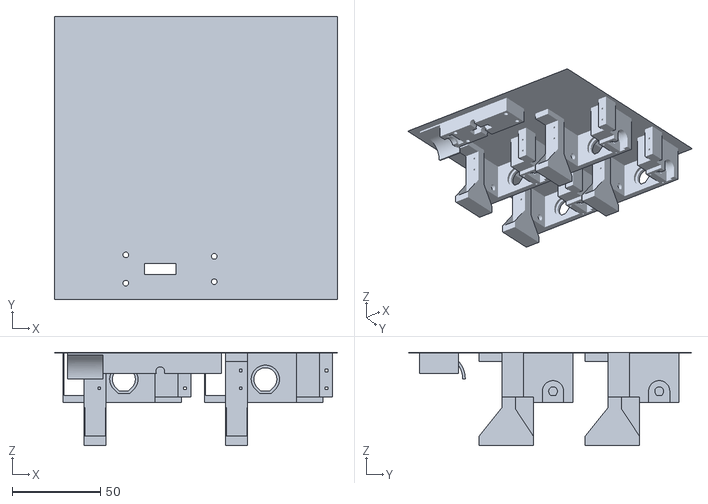
[picture p31: CAD file, 2014-11-03]
3D model/3d_printing/plate3.stl
160.0 x 160.0 x 52.6
