NiceCircuits/DrOctopus/(list of files, cad)

Other CAD files:
3D model/extruder/grip2a.stl
3D model/plywood_6mm.dxf
3D model/plywood_4mm.dxf
3D model/extruder/grip2.stl
3D model/3d_printing/plate1.ipt
3D model/3d_printing/plate1_small.ipt
3D model/3d_printing/plate2.ipt
3D model/3d_printing/plate3.ipt
3D model/3d_printing/plate4.ipt
3D model/3d_printing/plate5.ipt
3D model/3d_printing/plate6.ipt
3D model/arm/Bearing 699ZZ - 9x20x6mm.ipt
3D model/arm/arm.iam
3D model/arm/arm_coupler2.ipt
3D model/arm/coupler0.ipt
3D model/arm/elektronika.ipt
3D model/arm/segment0.iam
3D model/arm/segment0_coupler1.ipt
3D model/arm/segment0a.ipt
3D model/arm/segment0b.ipt
3D model/arm/segment0c.ipt
3D model/arm/segment1.iam
3D model/arm/segment1_coupler1.ipt
3D model/arm/segment1a.ipt
3D model/arm/segment1b.ipt
3D model/arm/segment1c.ipt
3D model/arm/segment2.iam
3D model/arm/segment2a.ipt
3D model/arm/segment2b.ipt
3D model/arm/segment3.iam
3D model/arm/segment3a.ipt
3D model/arm/servo 13kg BMS-630MG.ipt
3D model/arm/servo 33kg TGY-S8166M.ipt
3D model/arm/servo 4.8kg TGY-S4505B.ipt
3D model/arm/servo arm BMS-630MG tripple.ipt
3D model/arm/servo arm DS939HV round.ipt
3D model/arm/servo arm TGY-S4505B double large.ipt
3D model/arm/servo arm TGY-S4505B round large.ipt
3D model/arm/servo arm TGY-S8166M double.ipt
3D model/arm/servo arm TGY-S8166M long.ipt
3D model/arm/serwo 2.8kg DS939HV.ipt
3D model/extruder/MK7 gear.ipt
3D model/extruder/adapter.ipt
3D model/extruder/body.ipt
3D model/extruder/extruder.iam
3D model/extruder/fan.ipt
3D model/extruder/grip.ipt
3D model/extruder/servo HK15138.ipt
3D model/extruder/servo arm.ipt
3D model/extruder/tulejka M2x4.ipt
3D model/filament.ipt
3D model/full_instalation.iam
3D model/one_unit.iam
3D model/plywood_4mm.dwg
3D model/plywood_4mm.idw
3D model/plywood_6mm.dwg
3D model/plywood_6mm.idw
3D model/roll.dwg
3D model/roll.idw
3D model/roll.ipt
3D model/stand/Bearing 6006 ZZ - 30x55x13mm.ipt
3D model/stand/Thrust Bearing 51106 - 30x47x11mm.ipt
3D model/stand/Thrust Bearing 51109 - 45x66x14mm.ipt
3D model/stand/base.iam
3D model/stand/base_plate.ipt
3D model/stand/clip.ipt
3D model/stand/leg.ipt
3D model/stand/pin.ipt
3D model/stand/stand.iam
3D model/stand/stand_coupler1.ipt
3D model/stand/stand_plate1.ipt
3D model/stand/stand_plate2.ipt
3D model/stand/stand_plate3.ipt
3D model/stand/stand_plate4.ipt
design/mechanical/working area.ipt
