NiceCircuits/DrOctopus/pcb/powerPCB_v2.0/drOctopusPower_schematic.pdf

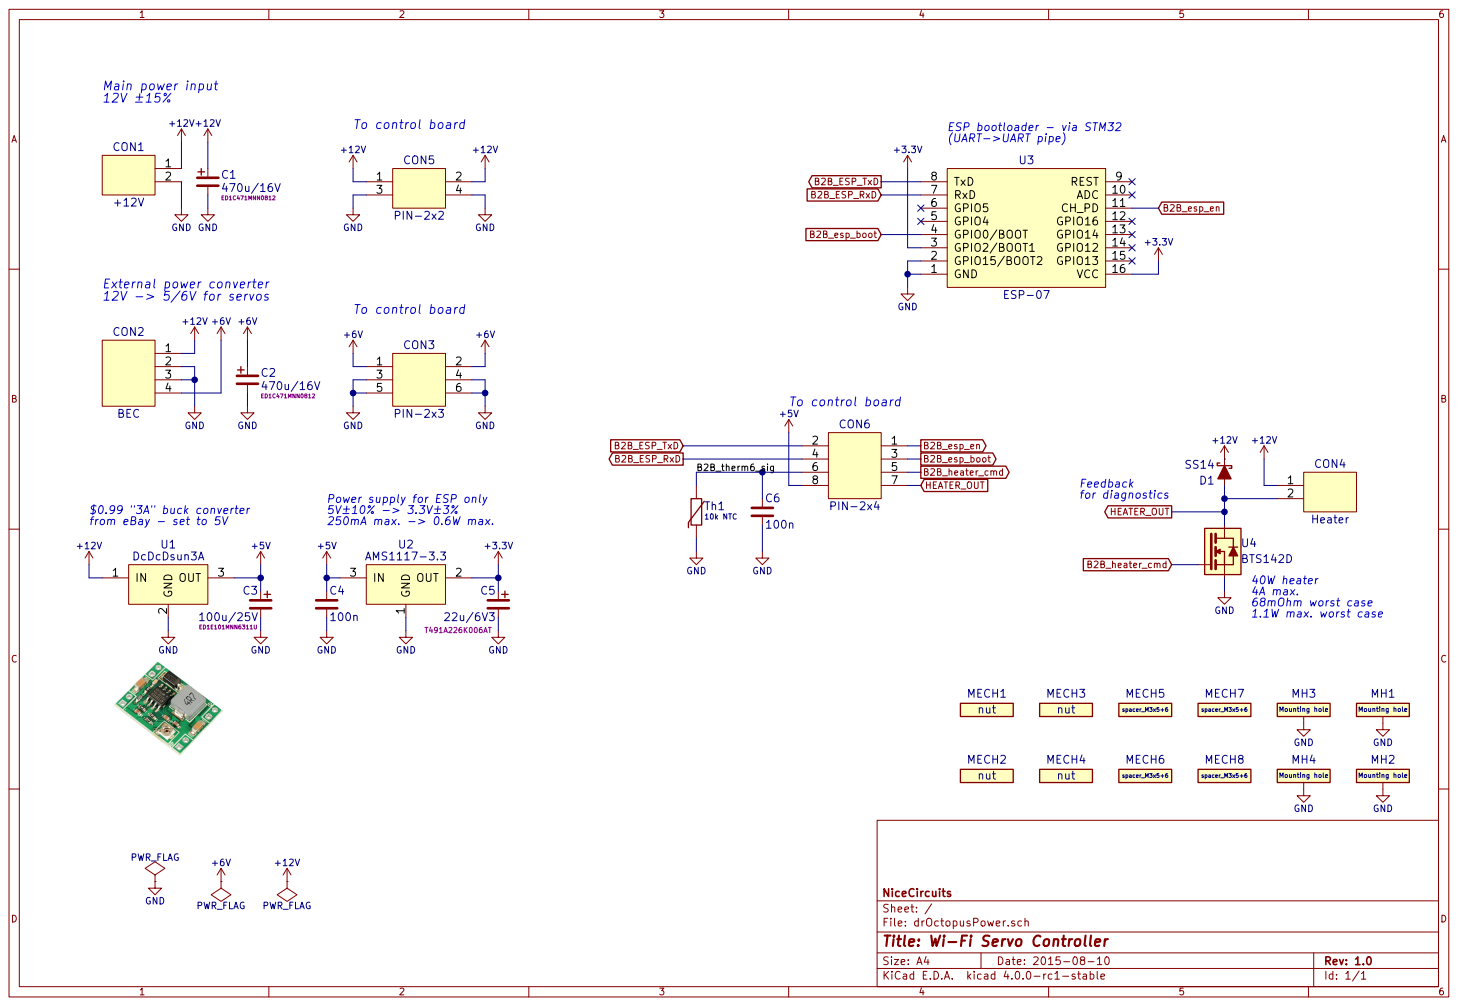
[picture p32: page 1]

1.1W max. worst case Main power input

from eBay - set to 5V

spacer_M3x5+6 Power supply for ESP only 5V±10% -> 3.3V±3%

Id: 1/1 Title: Wi-Fi Servo Controller
