NiceCircuits/DrOctopus/pcb/controlPCB_v2.0/drOctopusControl_schematic.pdf

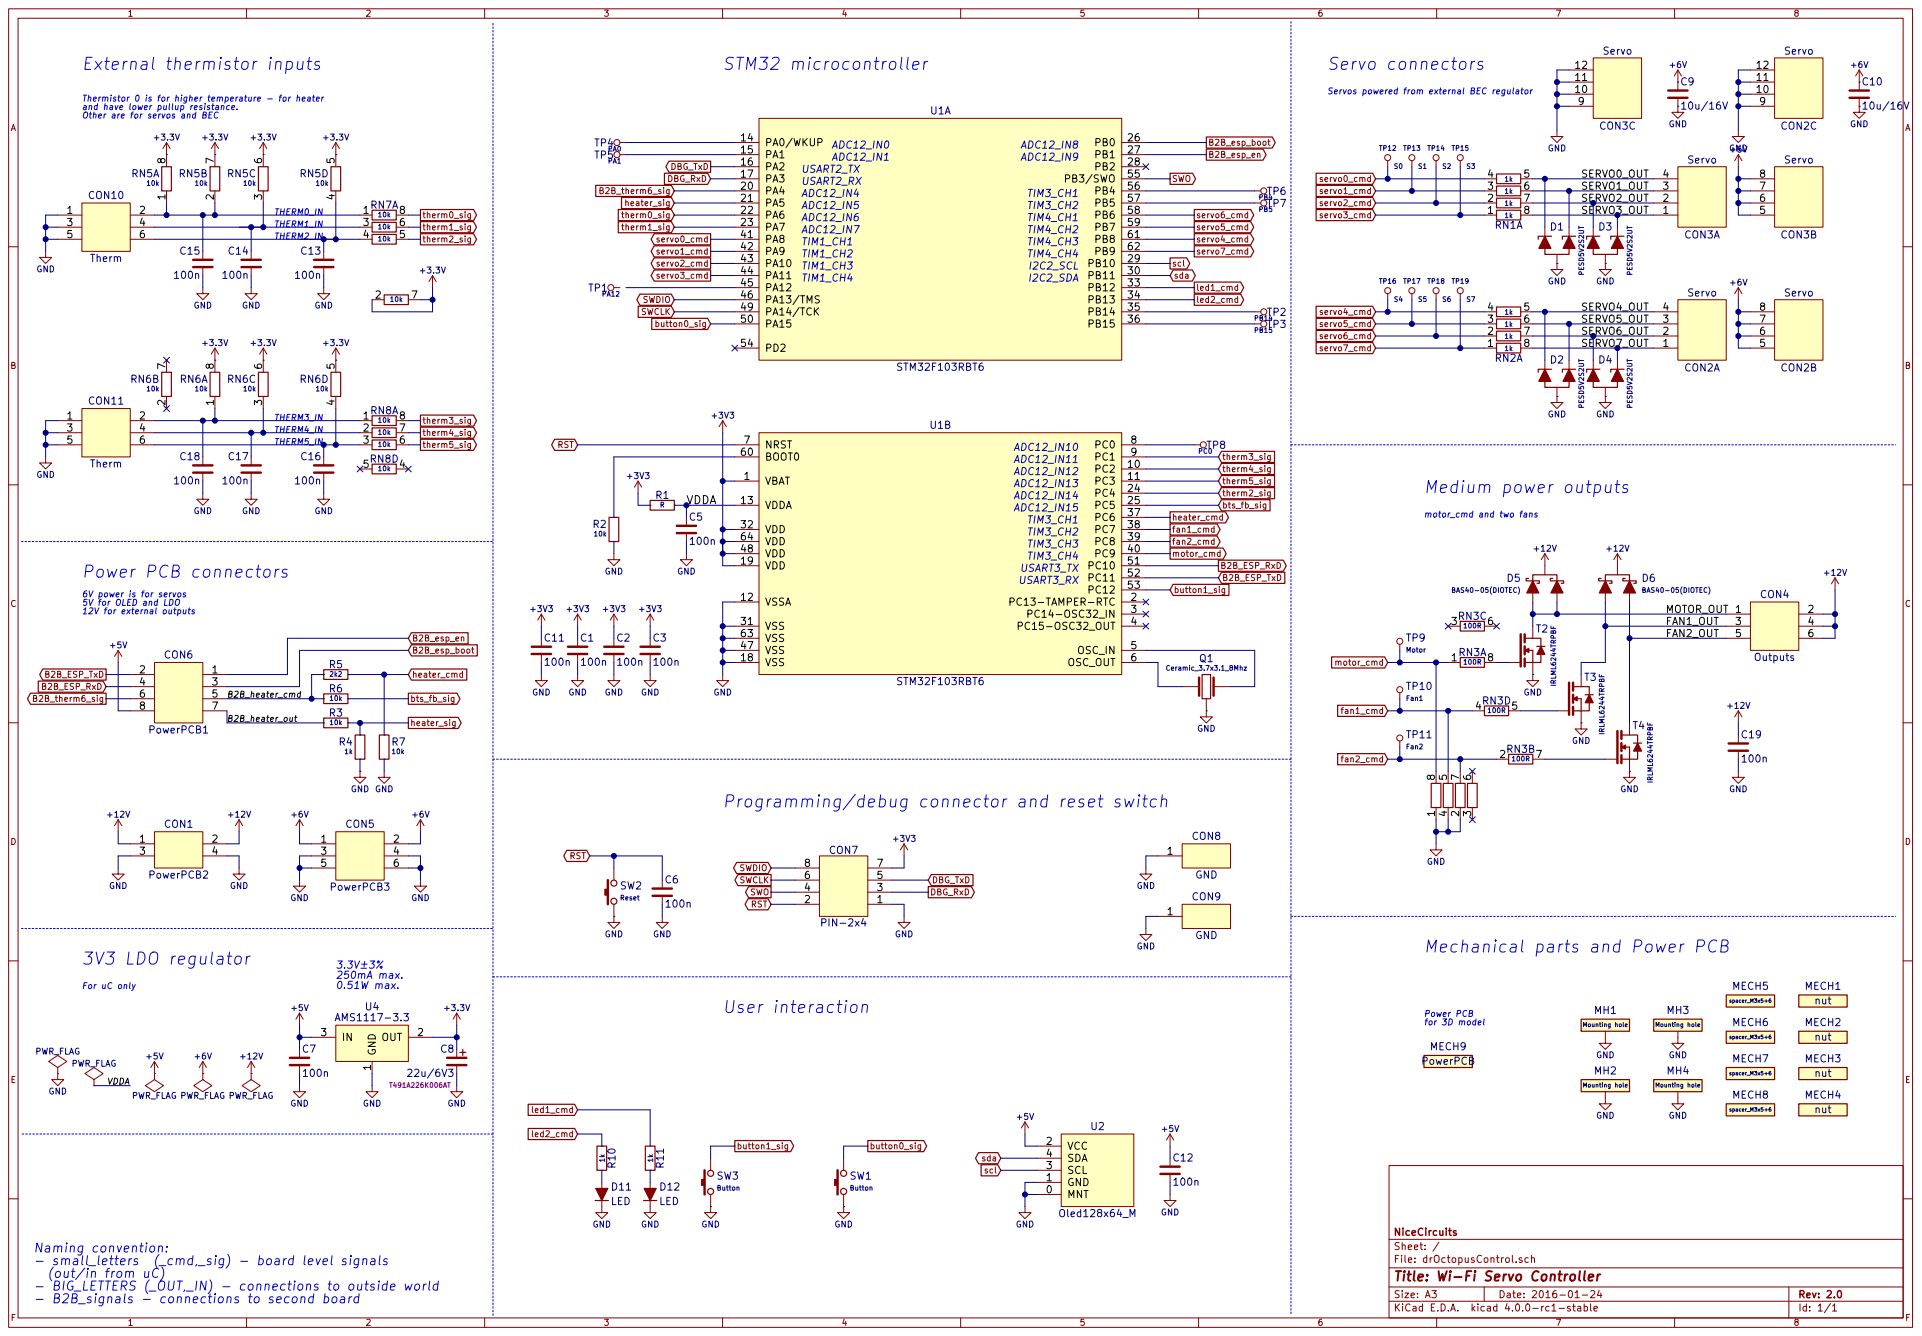
[picture p33: page 1]

and have lower pullup resistance. Other are for servos and BEC Power PCB connectors

button0_sig RST External thermistor inputs

Servos powered from external BEC regulator

Thermistor 0 is for higher temperature - for heater

Medium power outputs
motor_cmd and two fans Mechanical parts and Power PCB

6V power is for servos 5V for OLED and LDO
12V for external outputs

Programming/debug connector and reset switch

File: drOctopusControl.sch Sheet: / NiceCircuits

- small_letters (_cmd,_sig) - board level signals
(out/in from uC)
- BIG_LETTERS (_OUT,_IN) - connections to outside world
- B2B_signals - connections to second board

Id: 1/1 Title: Wi-Fi Servo Controller
