NiceCircuits/DrOctopus/3D model/plywood_4mm.pdf

P

R

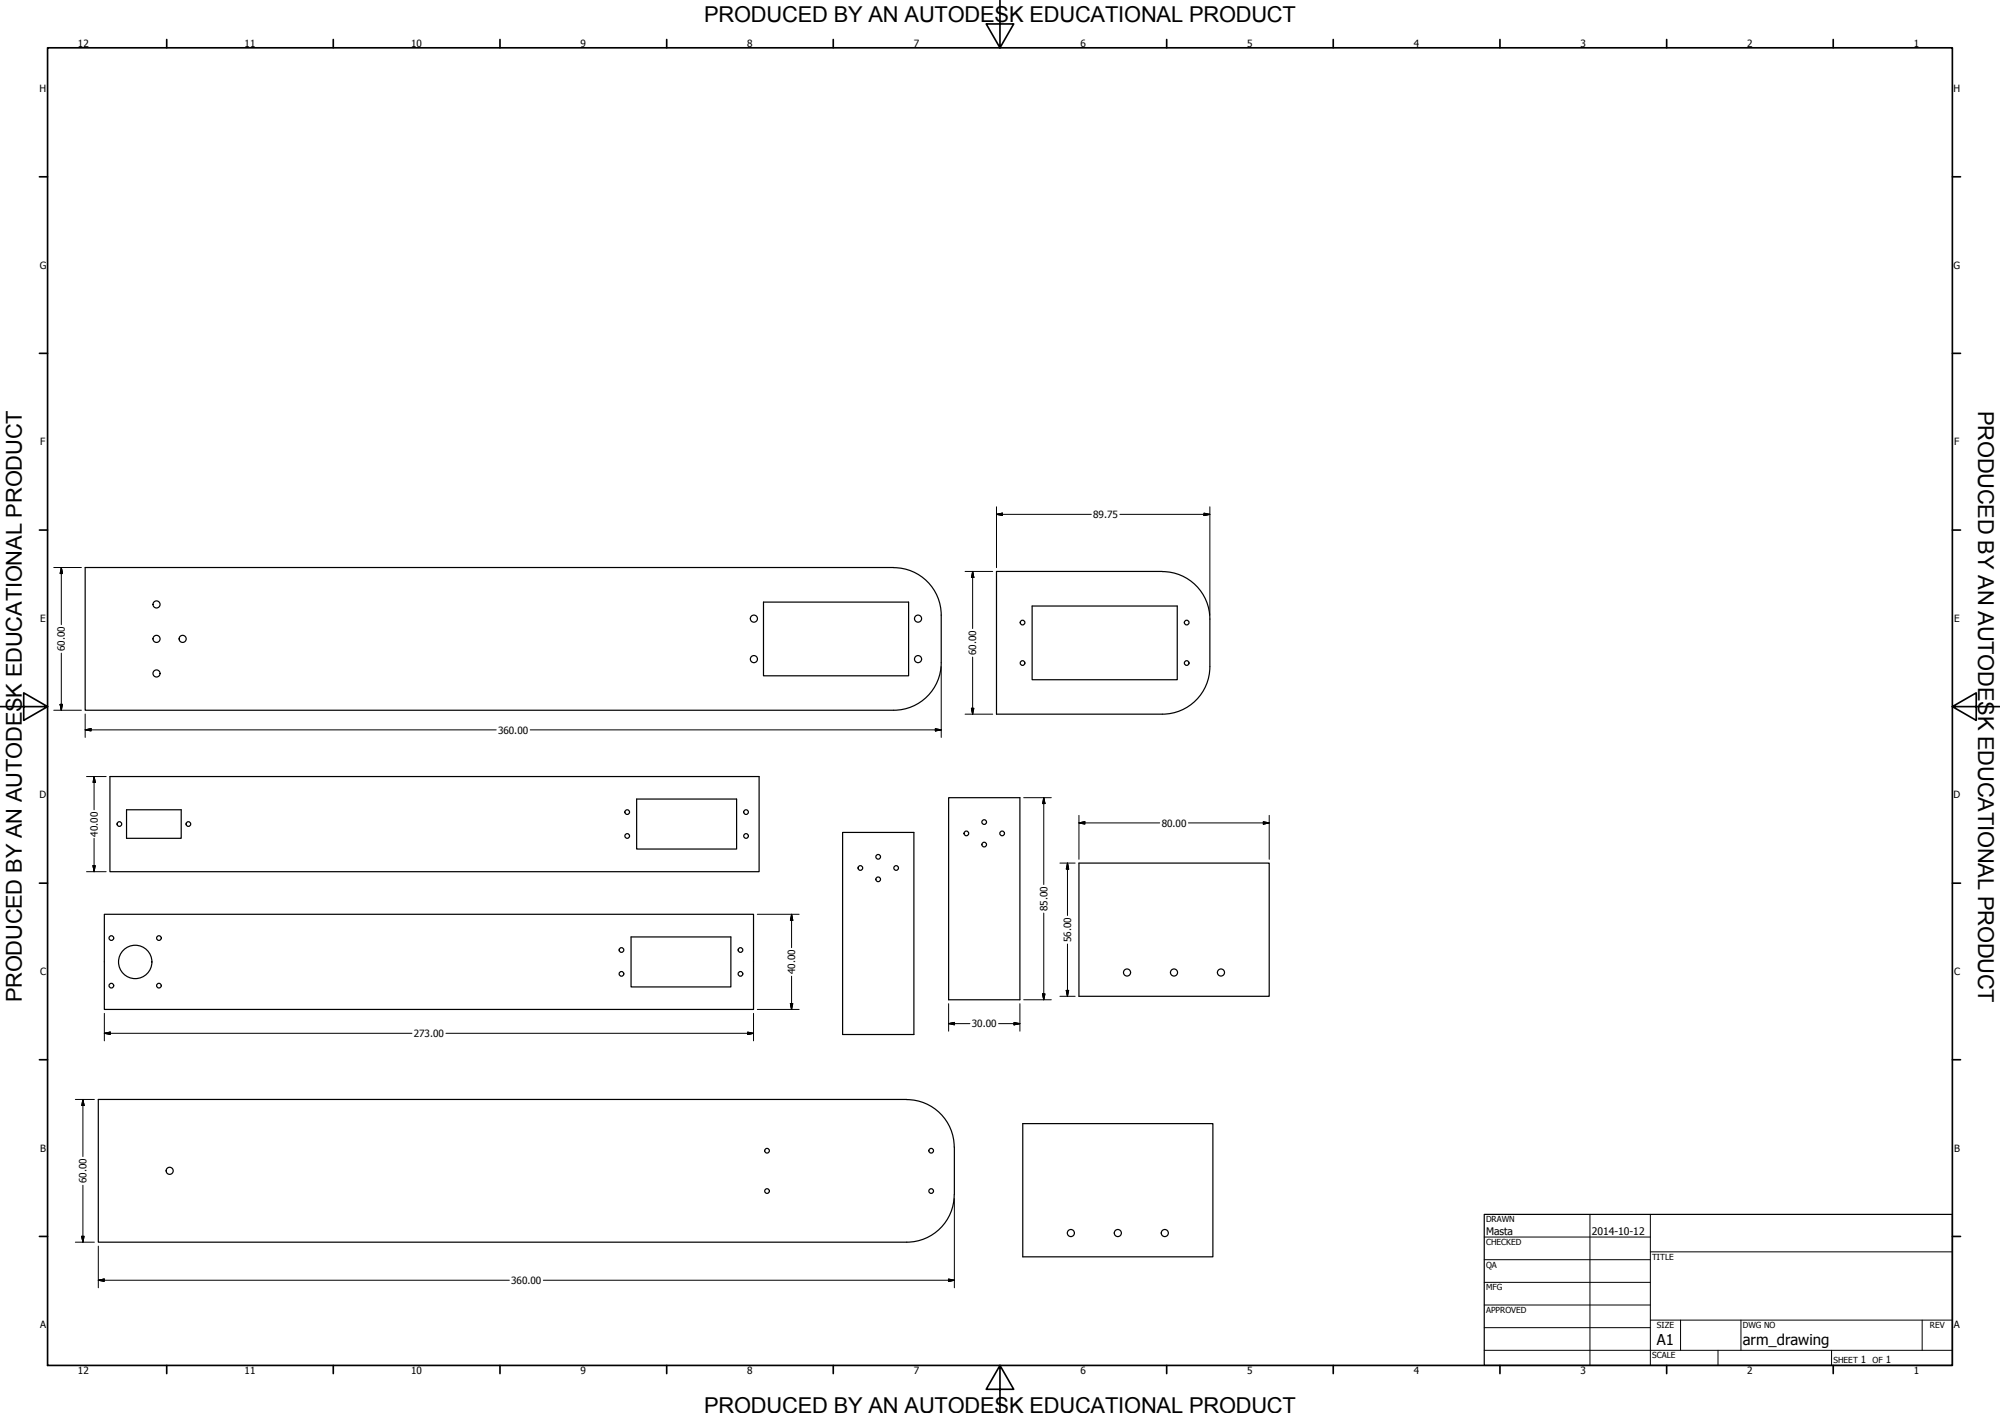
[picture p34: page 1]
TIO N

PRODUCED BY AN AUTODESK EDUCATIONAL PRODUCT
