NiceCircuits/DrOctopus/3D model/roll.pdf

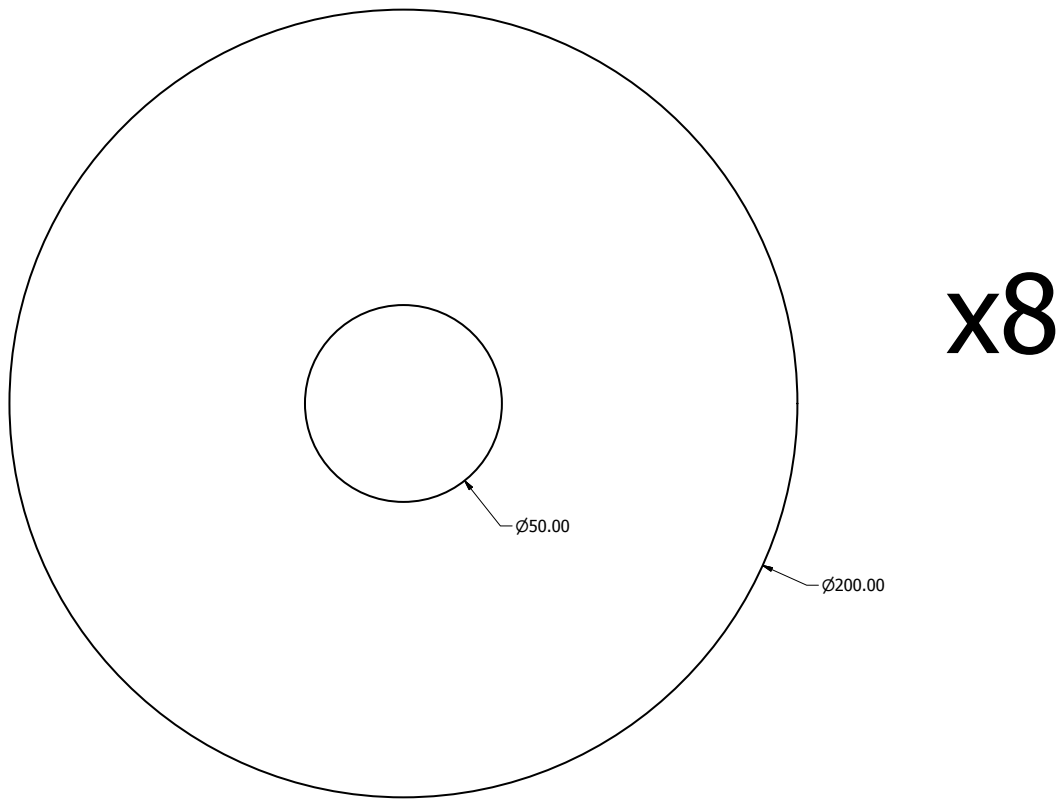
[picture p35: page 1]
TIO N

PRODUCED BY AN AUTODESK EDUCATIONAL PRODUCT

oll TITLE SIZE CSCALE
