NiceCircuits/DrOctopus/pcb/sim/servo_ESD.asc

C1: cap; {C}
C2: cap; {C}; Rser=1m
C3: cap; 100p
C4: cap; 100n
D1: diode; PESD5V2S2UT
D2: diode; DAN202UM
D3: diode; DAN202UM
R1: res; {R}
R2: res; {R}
R3: res; 1k5
R4: res; 100Meg
R5: res; 3m
R6: res; 10m
S1: sw; ""
V1: voltage; PULSE(0 5 1m 1n 1n 1m 20m)
V2: voltage; 5
V3: voltage; 4k
Named nets: 0, sig, esd, hbm
.param R 1k
.param C 10n
.model mysw SW(Ron=.1 Roff=1000000Meg Vt=0 Vh=0.5)
.include PESD5V2S2UT.prm
.tran 3m
