NiceCircuits/DrOctopus/pcb/controlPCB_v2.0/drOctopusControl.kicad_pcb

## KiCad design pcb/controlPCB_v2.0/drOctopusControl.kicad_pcb (2016-04-04)

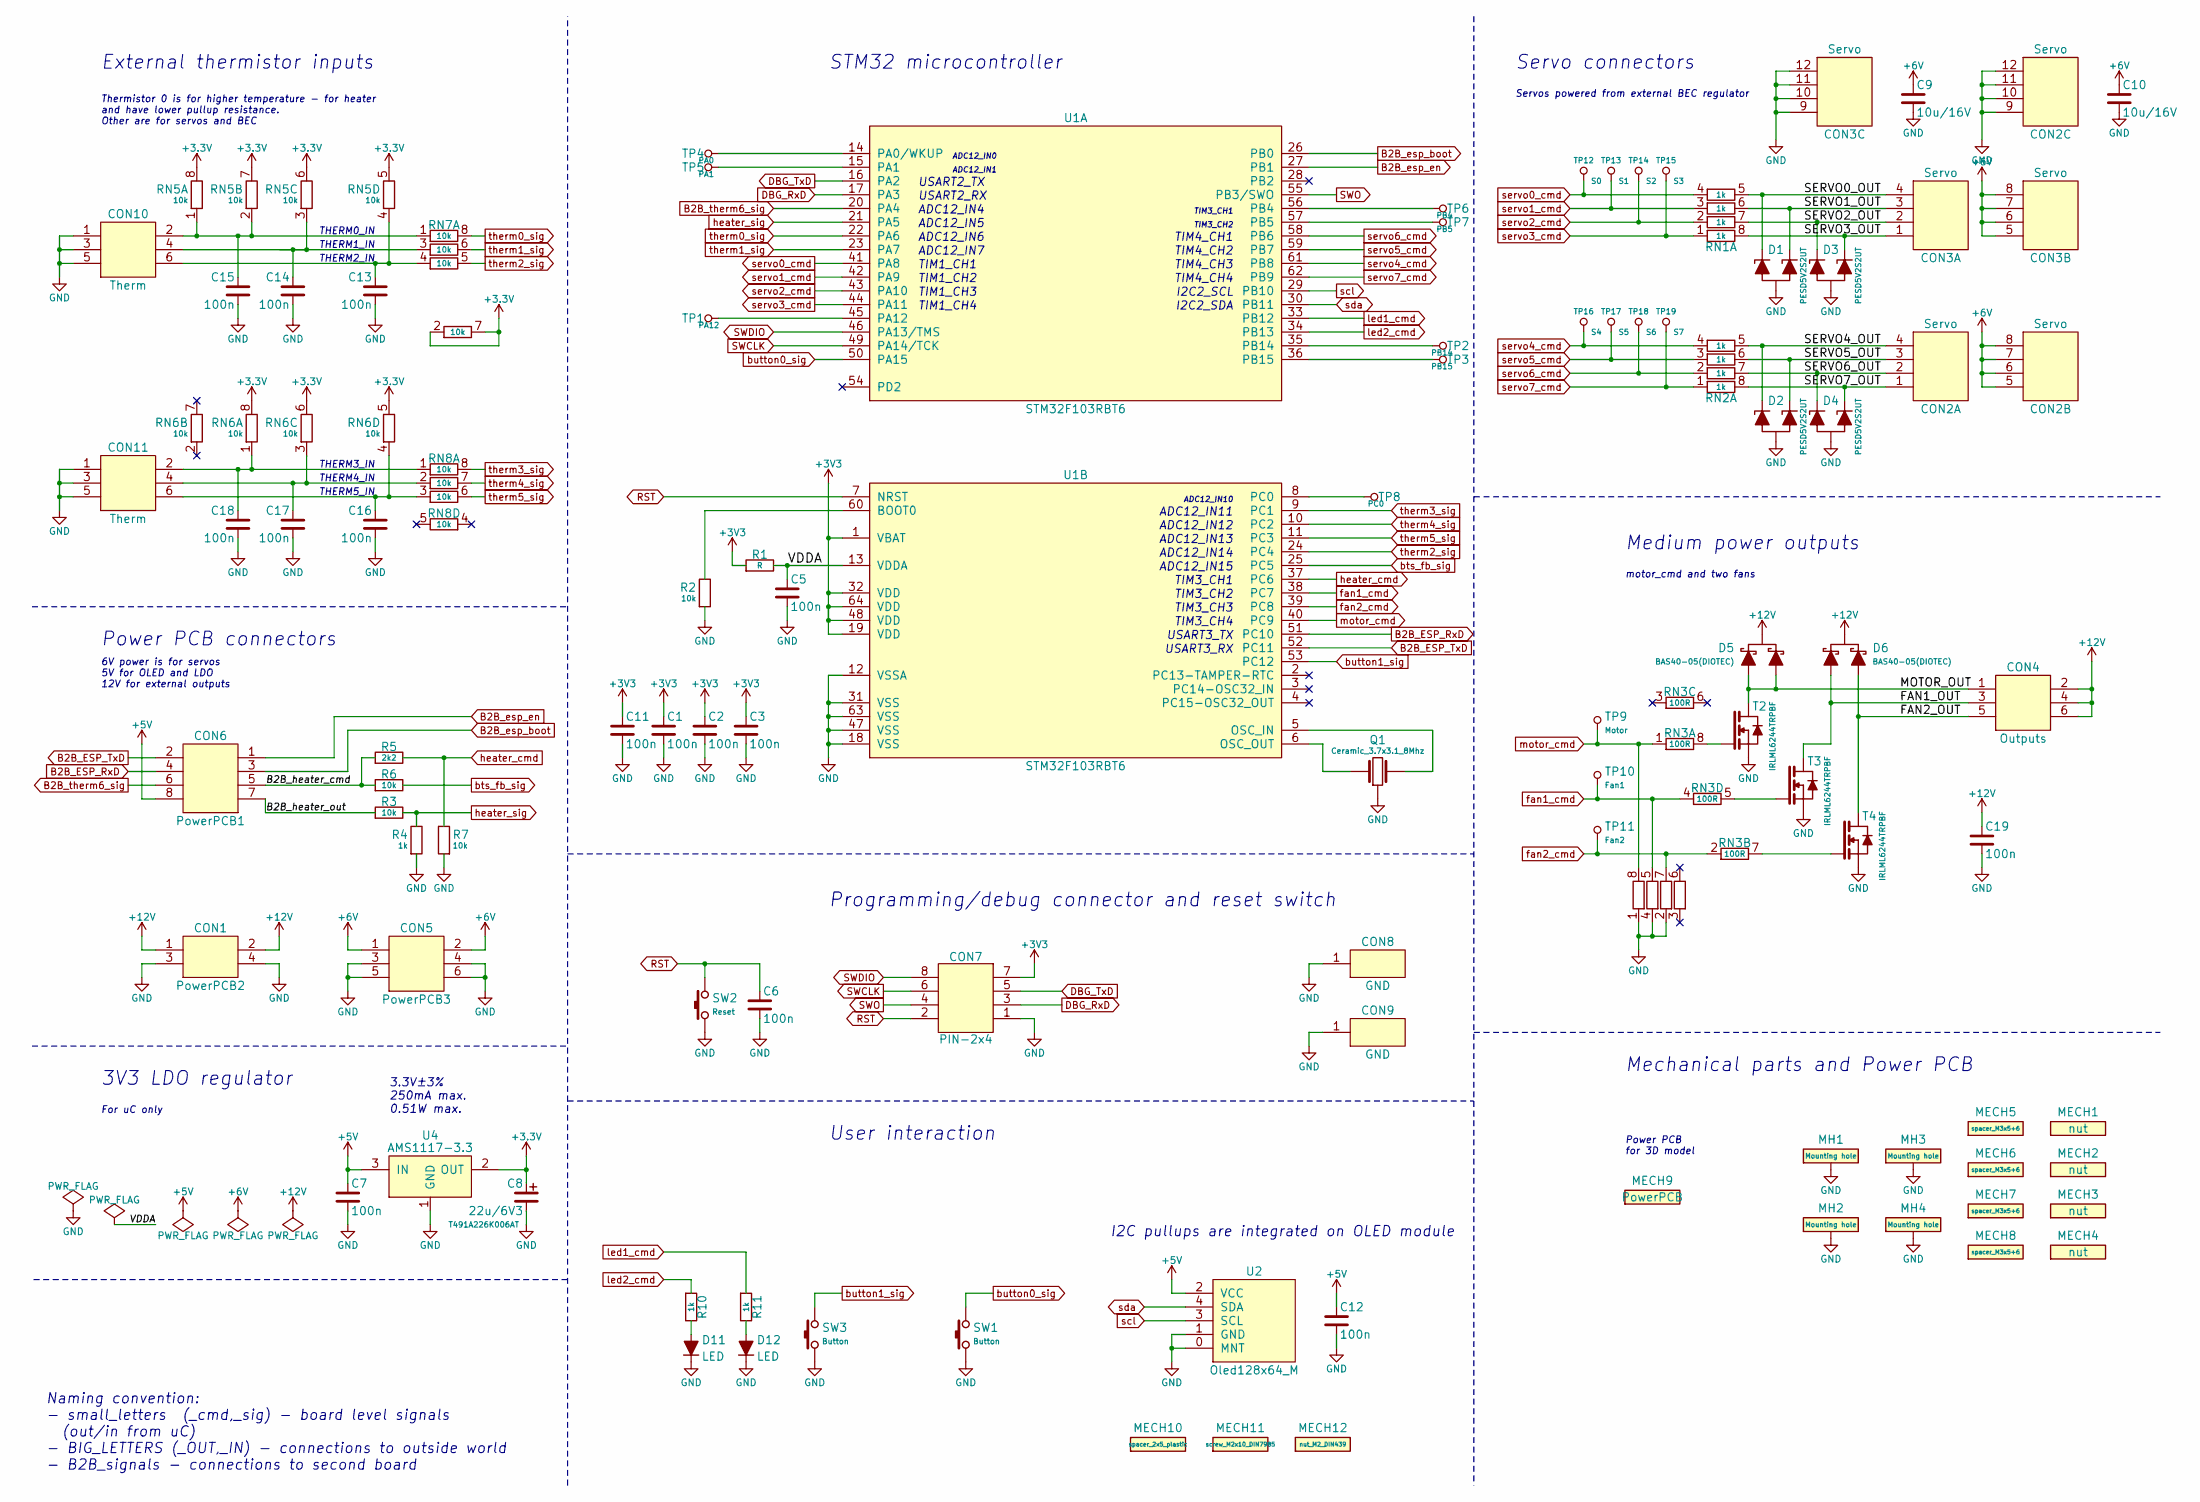
[picture p36: schematic drOctopusControl.sch, Wi-Fi Servo Controller]

Parts:
C1, C2, C3, C5, C6, C7, C11, C12, C13, C14, C15, C16, C17, C18, C19: 100n; 0603_N
C8: 22u/6V3; Tantal_A_N
C9, C10: 10u/16V; 0805_N
CON1: PowerPCB2; PIN-2x2_F_N
CON2, CON3: Servo; PIN-3x4_N
CON4: Outputs; PIN-2x3_N
CON5: PowerPCB3; PIN-2x3_F_N
CON6: PowerPCB1; PIN-2x4_F_N
CON7: PIN-2x4; PIN-2x4_N
CON8, CON9: GND; PIN-1x1_L
CON10, CON11: Therm; PIN-2x3_N
D1, D2, D3, D4: PESD5V2S2UT; SOT23-3_N
D5, D6: BAS40-05(DIOTEC); SOT23-3_N
D11, D12: LED; 0805_N
MECH1, MECH2, MECH3, MECH4: nut; nut_M3_DIN985
MECH5, MECH6, MECH7, MECH8: spacer_M3x5+6
MECH9: PowerPCB; dummy
MECH10: spacer_2x5_plastic
MECH11: screw_M2x10_DIN7985
MECH12: nut_M2_DIN439
MH1, MH2, MH3, MH4: Mounting hole; mounting_hole_3.2_7.5_plated_vias
Q1: Ceramic_3.7x3.1_8Mhz; 3.7x3.1_N
R1: R; 0603_R_N
R2, R3, R6, R7: 10k; 0603_R_N
R4, R10, R11: 1k; 0603_R_N
R5: 2k2; 0603_R_N
RN1, RN2: 1k; 4x0603_N
RN3: 100R; 4x0603_N
RN4, RN5, RN6, RN7, RN8: 10k; 4x0603_N
SW1, SW3: Button; MicroswitchSmd6x4_N
SW2: Reset; MicroswitchSmd6x4_N
T2, T3, T4: IRLML6244TRPBF; SOT23-3_N
TP1: PA12; TP_1mm
TP2: PB14; TP_1mm
TP3: PB15; TP_1mm
TP4: PA0; TP_1mm
TP5: PA1; TP_1mm
TP6: PB4; TP_1mm
TP7: PB5; TP_1mm
TP8: PC0; TP_1mm
TP9: Motor; TP_1mm
TP10: Fan1; TP_1mm
TP11: Fan2; TP_1mm
TP12: S0; TP_1mm
TP13: S1; TP_1mm
TP14: S2; TP_1mm
TP15: S3; TP_1mm
TP16: S4; TP_1mm
TP17: S5; TP_1mm
TP18: S6; TP_1mm
TP19: S7; TP_1mm
U1: STM32F103RBT6; QFP-64-0.5_N
U2: Oled128x64_M; Oled128x64_M_5.08N
U4: AMS1117-3.3; SOT223_N

Connections:
+5V: C7.1, C12.1, CON6.8, U2.2 (VCC), U4.3 (IN)
+6V: C9.1, C10.1, CON2.5 (1), CON2.6 (2), CON2.7 (3), CON2.8 (4), CON3.5 (1), CON3.6 (2), CON3.7 (3), CON3.8 (4), CON5.1, CON5.2
+12V: C19.1, CON1.1, CON1.2, CON4.2, CON4.4, CON4.6, D5.3 (C), D6.3 (C)
/B2B_heater_cmd: CON6.5, R5.1, R6.1
/B2B_heater_out: CON6.7, R3.1
/FAN1_OUT: CON4.3, D6.2 (A2), T3.3 (D)
/FAN2_OUT: CON4.5, D6.1 (A1), T4.3 (D)
/MOTOR_OUT: CON4.1, D5.1 (A1), D5.2 (A2), T2.3 (D)
/SERVO0_OUT: CON3.4, D1.2 (C2), RN1.5 (2)
/SERVO1_OUT: CON3.3, D1.1 (C1), RN1.6 (2)
/SERVO2_OUT: CON3.2, D3.2 (C2), RN1.7 (2)
/SERVO3_OUT: CON3.1, D3.1 (C1), RN1.8 (2)
/SERVO4_OUT: CON2.4, D2.2 (C2), RN2.5 (2)
/SERVO5_OUT: CON2.3, D2.1 (C1), RN2.6 (2)
/SERVO6_OUT: CON2.2, D4.2 (C2), RN2.7 (2)
/SERVO7_OUT: CON2.1, D4.1 (C1), RN2.8 (2)
/VDDA: C5.1, R1.2, U1.13 (VDDA)
B2B_ESP_RxD: CON6.4, U1.51 (PC10)
B2B_ESP_TxD: CON6.2, U1.52 (PC11)
B2B_esp_boot: CON6.3, U1.26 (PB0)
B2B_esp_en: CON6.1, U1.27 (PB1)
B2B_therm6_sig: CON6.6, U1.20 (PA4)
DBG_RxD: CON7.3, U1.17 (PA3)
DBG_TxD: CON7.5, U1.16 (PA2)
GND: C1.2, C2.2, C3.2, C5.2, C6.2, C7.2, C8.2, C9.2, C10.2, C11.2, C12.2, C13.2, C14.2, C15.2, C16.2, C17.2, C18.2, C19.2, CON1.3, CON1.4, CON2.9 (1), CON2.10 (2), CON2.11 (3), CON2.12 (4), CON3.9 (1), CON3.10 (2), CON3.11 (3), CON3.12 (4), CON5.3, CON5.4, CON5.5, CON5.6, CON7.1, CON8.1, CON9.1, CON10.1, CON10.3, CON10.5, CON11.1, CON11.3, CON11.5, D1.3 (A), D2.3 (A), D3.3 (A), D4.3 (A), D11.1 (A), D12.1 (A), MH1.1, MH2.1, MH3.1, MH4.1, Q1.2, R2.1, R4.1, R7.1, RN4.1, RN4.2 (1), RN4.4 (1), SW1.1, SW2.1, SW3.1, T2.2 (S), T3.2 (S), T4.2 (S), U1.12 (VSSA), U1.18 (VSS), U1.31 (VSS), U1.47 (VSS), U1.63 (VSS), U2.0 (MNT), U2.1 (GND), U4.1 (GND)
unnamed: C13.1, CON10.6, RN5.4 (1), RN7.4 (1)
unnamed: C14.1, CON10.4, RN5.3 (1), RN7.3 (1)
unnamed: C15.1, CON10.2, RN5.1, RN5.2 (1), RN7.1
unnamed: C16.1, CON11.6, RN6.4 (1), RN8.3 (1)
unnamed: C17.1, CON11.4, RN6.3 (1), RN8.2 (1)
unnamed: C18.1, CON11.2, RN6.1, RN8.1
unnamed: D11.2 (C), R10.2
unnamed: D12.2 (C), R11.2
unnamed: Q1.1, U1.6 (OSC_OUT)
unnamed: Q1.3, U1.5 (OSC_IN)
unnamed: R2.2, U1.60 (BOOT0)
unnamed: RN3.5 (2), T3.1 (G)
unnamed: RN3.7 (2), T4.1 (G)
unnamed: RN3.8 (2), T2.1 (G)
unnamed: TP1.1, U1.45 (PA12)
unnamed: TP2.1, U1.35 (PB14)
unnamed: TP3.1, U1.36 (PB15)
unnamed: TP4.1, U1.14 (PA0/WKUP)
unnamed: TP5.1, U1.15 (PA1)
unnamed: TP6.1, U1.56 (PB4)
unnamed: TP7.1, U1.57 (PB5)
unnamed: TP8.1, U1.8 (PC0)
RST: C6.1, CON7.2, SW2.2, U1.7 (NRST)
SWCLK: CON7.6, U1.49 (PA14/TCK)
SWDIO: CON7.8, U1.46 (PA13/TMS)
SWO: CON7.4, U1.55 (PB3/SWO)
bts_fb_sig: R6.2, U1.25 (PC5)
button0_sig: SW1.2, U1.50 (PA15)
button1_sig: SW3.2, U1.53 (PC12)
fan1_cmd: RN3.4 (1), RN4.5 (2), TP10.1, U1.38 (PC7)
fan2_cmd: RN3.2 (1), RN4.7 (2), TP11.1, U1.39 (PC8)
heater_cmd: R5.2, R7.2, U1.37 (PC6)
heater_sig: R3.2, R4.2, U1.21 (PA5)
led1_cmd: R11.1, U1.33 (PB12)
led2_cmd: R10.1, U1.34 (PB13)
motor_cmd: RN3.1, RN4.8 (2), TP9.1, U1.40 (PC9)
scl: U1.29 (PB10), U2.3 (SCL)
sda: U1.30 (PB11), U2.4 (SDA)
servo0_cmd: RN1.4 (1), TP12.1, U1.41 (PA8)
servo1_cmd: RN1.3 (1), TP13.1, U1.42 (PA9)
servo2_cmd: RN1.2 (1), TP14.1, U1.43 (PA10)
servo3_cmd: RN1.1, TP15.1, U1.44 (PA11)
servo4_cmd: RN2.4 (1), TP16.1, U1.61 (PB8)
servo5_cmd: RN2.3 (1), TP17.1, U1.59 (PB7)
servo6_cmd: RN2.2 (1), TP18.1, U1.58 (PB6)
servo7_cmd: RN2.1, TP19.1, U1.62 (PB9)
therm0_sig: RN7.8 (2), U1.22 (PA6)
therm1_sig: RN7.6 (2), U1.23 (PA7)
therm2_sig: RN7.5 (2), U1.24 (PC4)
therm3_sig: RN8.8 (2), U1.9 (PC1)
therm4_sig: RN8.7 (2), U1.10 (PC2)
therm5_sig: RN8.6 (2), U1.11 (PC3)

Notes on the sheet:
3.3V±3% 250mA max. 0.51W max.
ADC12_IN4
ADC12_IN5
ADC12_IN6
ADC12_IN7
ADC12_IN14
ADC12_IN15
ADC12_IN10
ADC12_IN11
ADC12_IN12
ADC12_IN13
USART2_TX
USART2_RX
I2C2_SCL
I2C2_SDA
TIM3_CH1
TIM3_CH2
TIM3_CH3
TIM3_CH4
TIM1_CH1
TIM1_CH2
TIM1_CH3
TIM1_CH4
USART3_TX
USART3_RX
TIM4_CH1
TIM4_CH2
TIM4_CH3
TIM4_CH4
THERM0_IN
THERM1_IN
THERM2_IN
THERM3_IN
THERM4_IN
THERM5_IN
External thermistor inputs
Thermistor 0 is for higher temperature - for heater and have lower pullup resistance. Other are for servos and BEC
Power PCB connectors
6V power is for servos 5V for OLED and LDO 12V for external outputs
3V3 LDO regulator
For uC only
STM32 microcontroller
Programming/debug connector and reset switch
User interaction
Servo connectors
Servos powered from external BEC regulator
Medium power outputs
motor_cmd and two fans
Mechanical parts and Power PCB
Power PCB for 3D model
Naming convention: - small_letters (_cmd,_sig) - board level signals (out/in from uC) - BIG_LETTERS (_OUT,_IN) - connections to outside world - B2B_signals - connections to second board
I2C pullups are integrated on OLED module
ADC12_IN1
ADC12_IN0

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
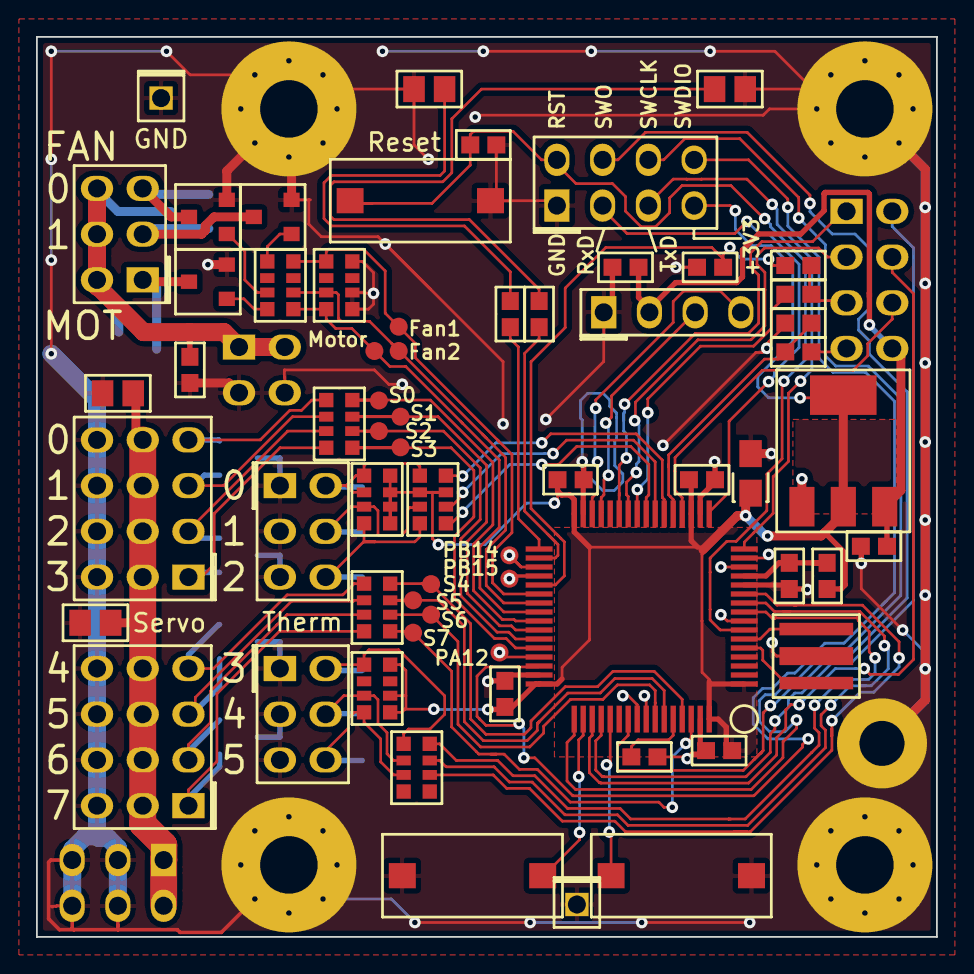
[picture p37: board drOctopusControl.kicad_pcb from above]

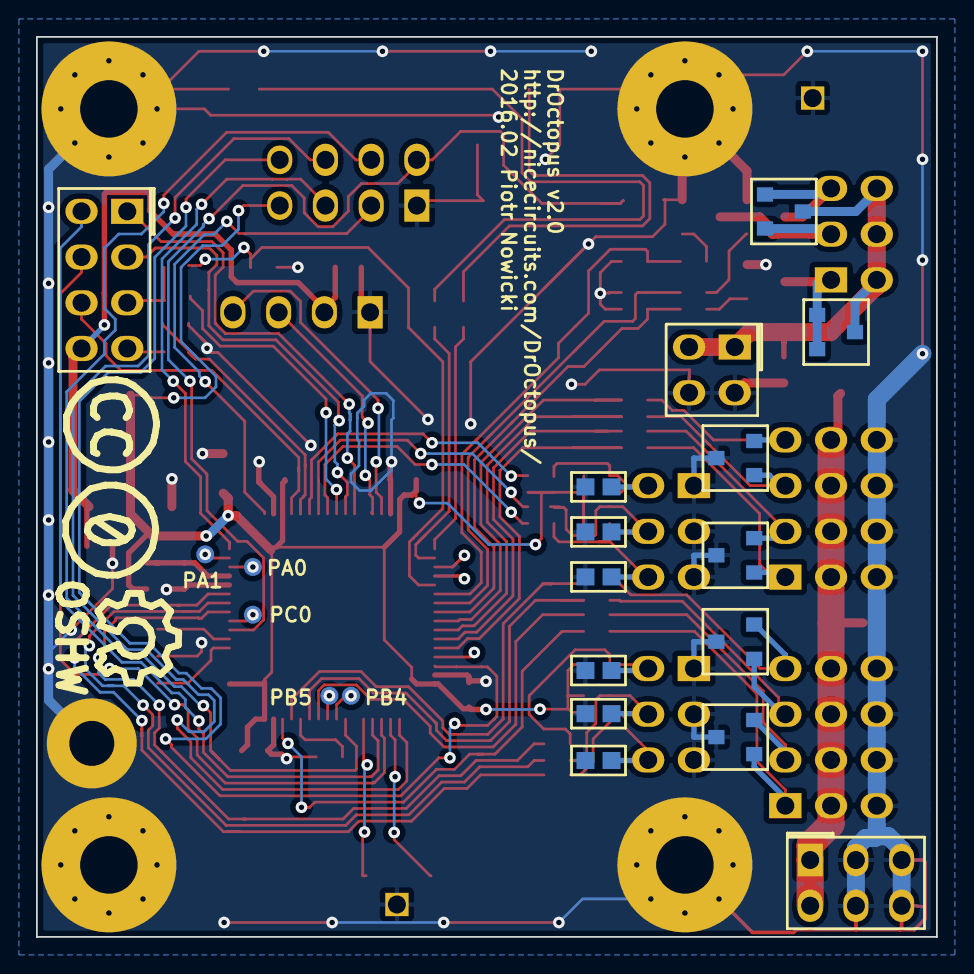
[picture p38: board drOctopusControl.kicad_pcb from below]

Board: 2 copper layers, 50.0 x 50.0 mm, 101 parts (27 on the bottom side), 78 nets.

Other parts of the board:
SYM: Symbol_OSHW-Logo_SilkScreen_07Jul2012; Symbol_OSHW-Logo_SilkScreen
Sym: Symbol_CreativeCommonsPublicDomain_SilkScreenTop_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; Symbol_CreativeCommonsPublicDomain_SilkScreenTop_SmallMinim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
