NiceCircuits/DrOctopus/pcb/powerPCB_v2.0/drOctopusPower.kicad_pcb

## KiCad design pcb/powerPCB_v2.0/drOctopusPower.kicad_pcb (2016-02-04)

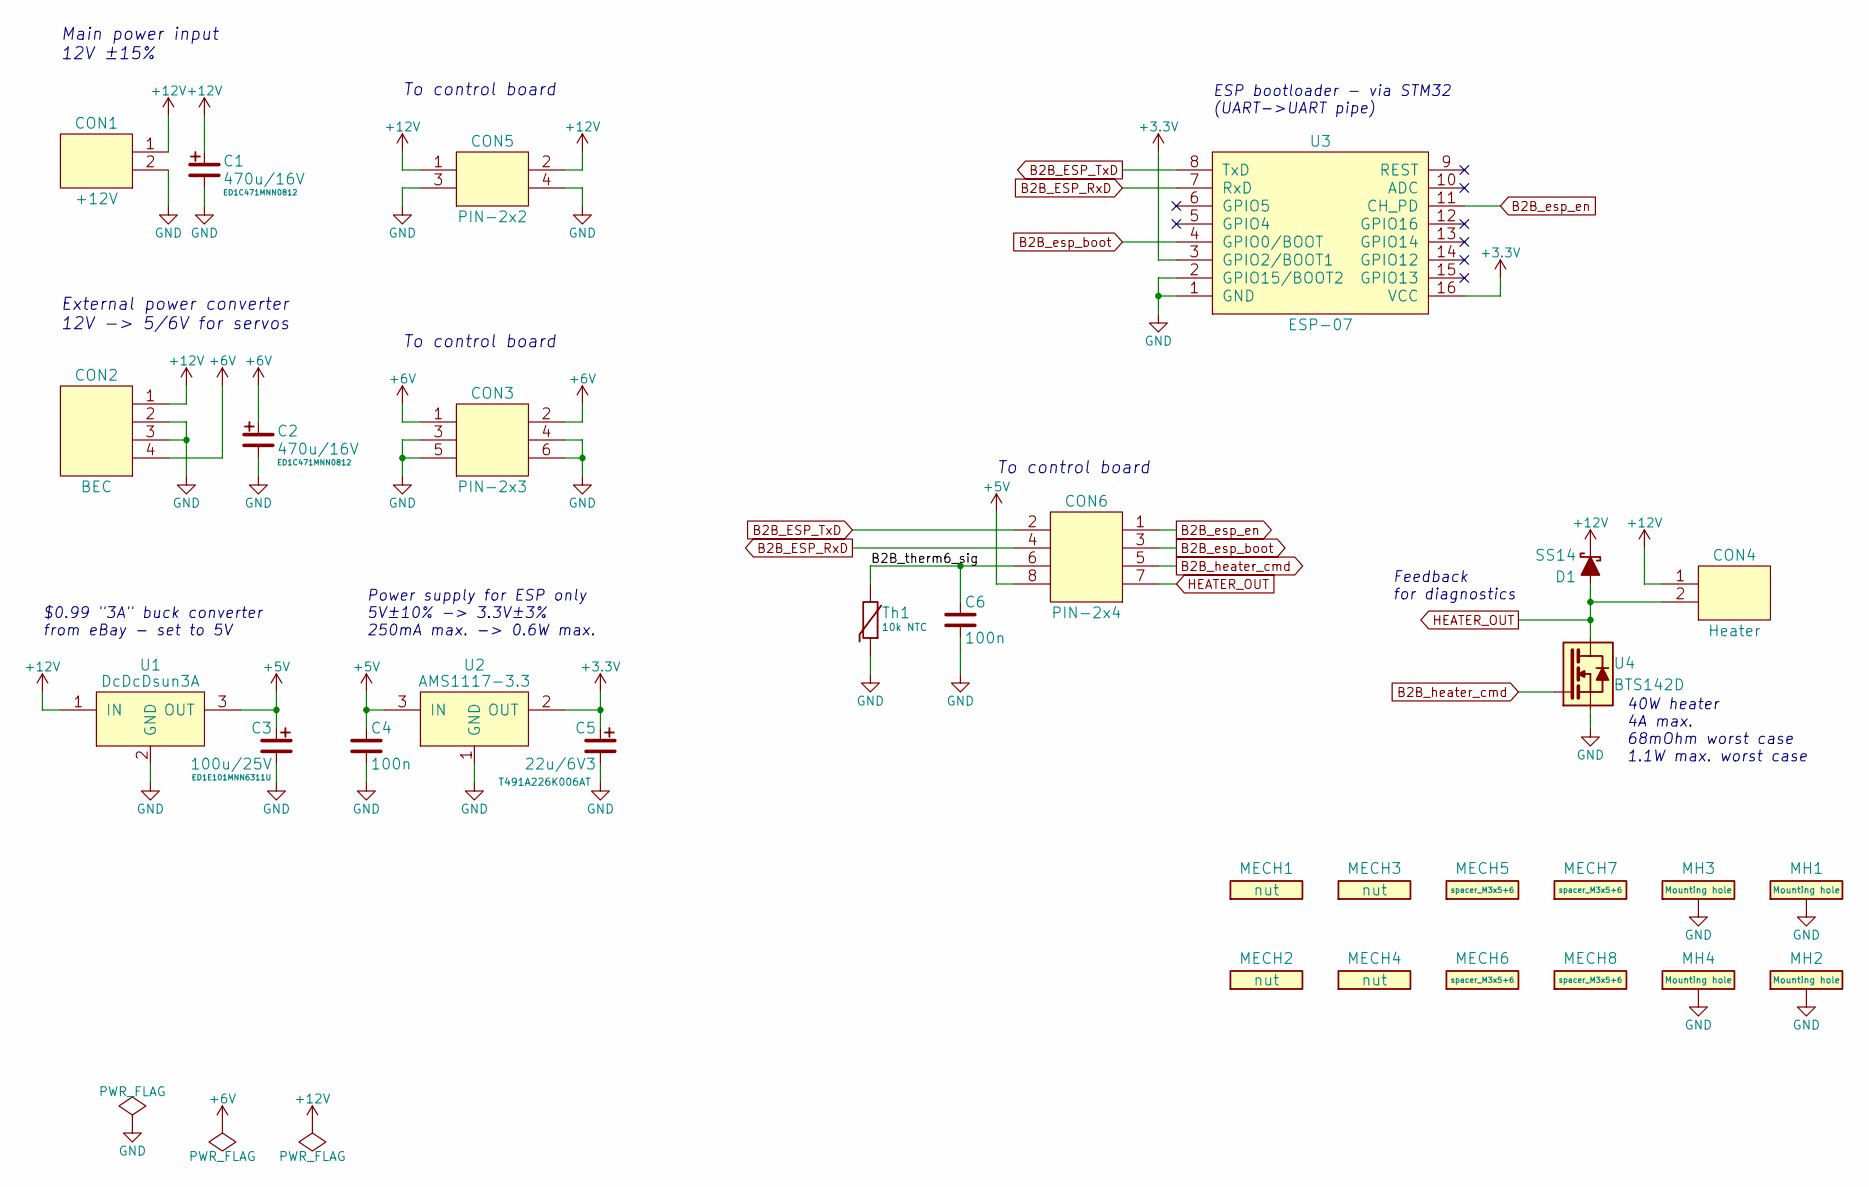
[picture p39: schematic drOctopusPower.sch, Wi-Fi Servo Controller]

Parts:
C1, C2: 470u/16V; Cpol_8.0_12.0_HR_N
C3: 100u/25V; Cpol_6.3_11.0_HR_N
C4, C6: 100n; 0603_N
C5: 22u/6V3; Tantal_A_N
CON1: +12V; EDG-5.08mm-2_N
CON2: BEC; EDG-5.08mm-4_N
CON3: PIN-2x3; PIN-2x3_N
CON4: Heater; EDG-5.08mm-2_N
CON5: PIN-2x2; PIN-2x2_N
CON6: PIN-2x4; PIN-2x4_N
D1: SS14; SMA_N
MECH1, MECH2, MECH3, MECH4: nut; nut_M3_DIN985
MECH5, MECH6, MECH7, MECH8: spacer_M3x5+6
MH1, MH2, MH3, MH4: Mounting hole; mounting_hole_3.2_7.5_plated_vias
Th1: 10k NTC; 0603_N
U1: DcDcDsun3A; DcDcDsun3A_5.08N
U2: AMS1117-3.3; SOT223_N
U3: ESP-07; ESP-07_N
U4: BTS142D; D-PAK_N

Connections:
+3V3: C5.1, U2.2 (OUT), U3.3 (GPIO2/BOOT1), U3.16 (VCC)
+5V: C3.1, C4.1, CON6.8, U1.3 (OUT), U2.3 (IN)
+6V: C2.1, CON2.4, CON3.1, CON3.2
+12V: C1.1, CON1.1, CON2.1, CON4.1, CON5.1, CON5.2, D1.1 (A), U1.1 (IN)
/B2B_therm6_sig: C6.1, CON6.6, Th1.2
B2B_ESP_RxD: CON6.4, U3.7 (RxD)
B2B_ESP_TxD: CON6.2, U3.8 (TxD)
B2B_esp_boot: CON6.3, U3.4 (GPIO0/BOOT)
B2B_esp_en: CON6.1, U3.11 (CH_PD)
B2B_heater_cmd: CON6.5, U4.1 (G)
GND: C1.2, C2.2, C3.2, C4.2, C5.2, C6.2, CON1.2, CON2.2, CON2.3, CON3.3, CON3.4, CON3.5, CON3.6, CON5.3, CON5.4, MH1.1, MH2.1, MH3.1, MH4.1, Th1.1, U1.2 (GND), U2.1 (GND), U3.1 (GND), U3.2 (GPIO15/BOOT2), U4.3 (S)
HEATER_OUT: CON4.2, CON6.7, D1.2 (C), U4.2 (D)

Notes on the sheet:
Power supply for ESP only 5V±10% -> 3.3V±3% 250mA max. -> 0.6W max.
40W heater 4A max. 68mOhm worst case 1.1W max. worst case
Main power input 12V ±15%
External power converter 12V -> 5/6V for servos
$0.99 "3A" buck converter from eBay - set to 5V
ESP bootloader - via STM32 (UART->UART pipe)
Feedback for diagnostics
To control board

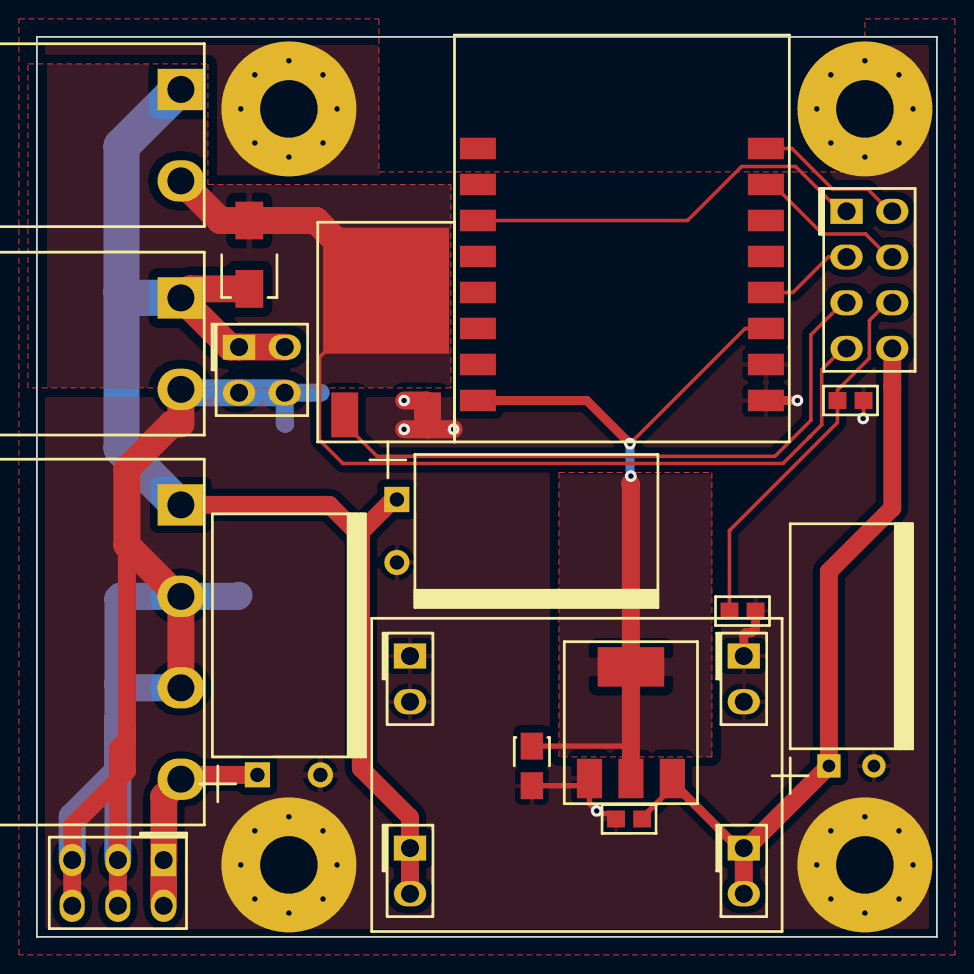
[picture p40: board drOctopusPower.kicad_pcb from above]

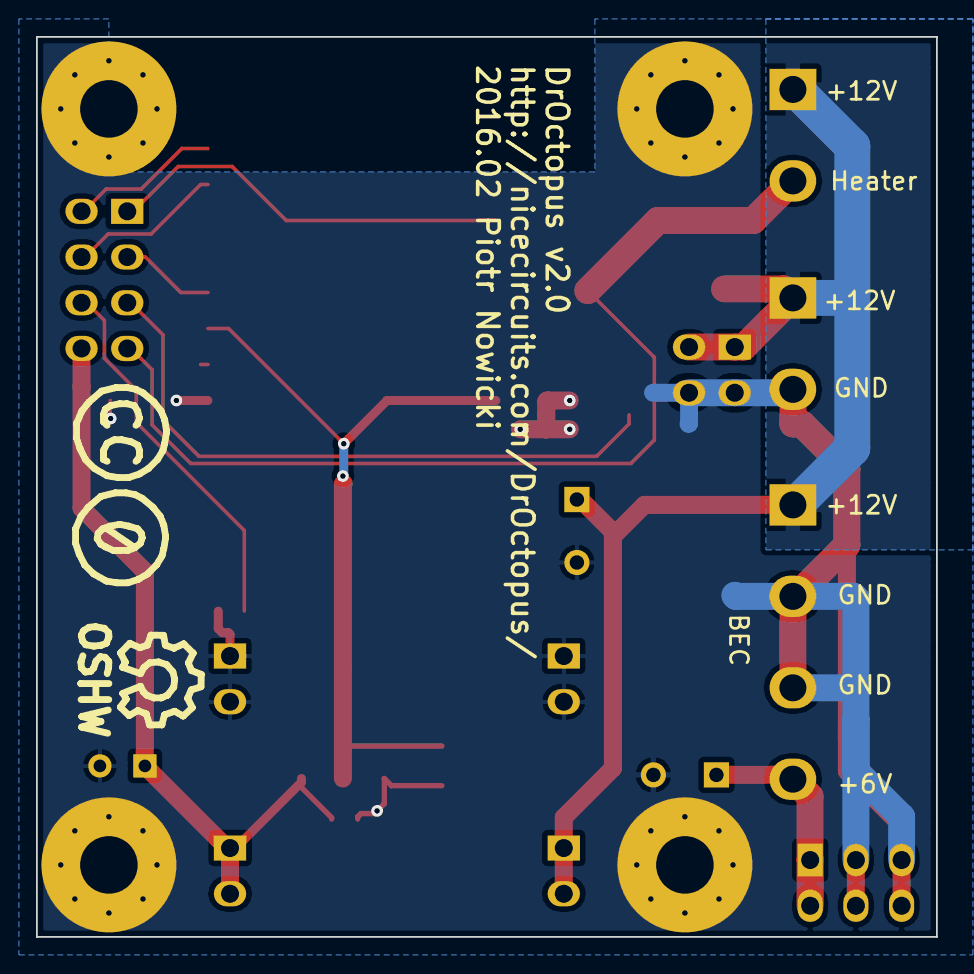
[picture p41: board drOctopusPower.kicad_pcb from below]

Board: 2 copper layers, 50.0 x 50.0 mm, 32 parts (6 on the bottom side), 12 nets.

Other parts of the board:
SYM: Symbol_OSHW-Logo_SilkScreen_07Jul2012; Symbol_OSHW-Logo_SilkScreen
Sym: Symbol_CreativeCommonsPublicDomain_SilkScreenTop_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; Symbol_CreativeCommonsPublicDomain_SilkScreenTop_SmallMinim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
