NiceCircuits/DrOctopus/soft/drOctopusArduinoTest/.ino.cpp

//This is a automatic generated file
//Please do not modify this file
//If you touch this file your change will be overwritten during the next build
//This file has been generated on 2015-11-10 21:30:38

#include "Arduino.h"
#include <SoftwareSerial.h>
#include <espduino.h>
#include <mqtt.h>
void wifiCb(void* response) ;
void mqttConnected(void* response) ;
void mqttDisconnected(void* response) ;
void mqttData(void* response) ;
void mqttPublished(void* response) ;
void setup() ;
void loop() ;

#include "drOctopusArduinoTest.ino"
