NiceCircuits/DrOctopus/(commit log)

2014-08-02 Start design
    [design.xls]
2014-08-03 Select motors
    [design.xls]
2014-10-09 Start 3D modeling
    [BOM.xls, Bearing 3202 2RS - 15x35x15,9 mm.ipt, arm.iam, coupler0.ipt, segment0.iam, segment1.iam, segment1a.ipt, segment1b.ipt]
2014-10-10 Straight version
    [arm.iam, segment1.iam, segment1a.ipt, segment1b.ipt, segment2.iam, segment2a.ipt]
2014-10-10 3D design
    [arm.iam, arm.stp, segment1.iam, segment1a.ipt, segment2.iam, segment2a.ipt]
2014-10-12 Continue 3D modeling
    [Bearing 3202 2RS - 15x35x15,9 mm.ipt, Bearing 6006 ZZ - 30x55x13mm.ipt, Bearing 699ZZ - 9x20x6mm.ipt, Thrust Bearing 51106 - 30x47x11mm.ipt, arm.iam, arm_drawing.idw, base.iam, base_plate.ipt]
2014-10-13 Fix small issues
    [arm.iam, segment0.iam, segment0a.ipt, segment1.iam, segment1a.ipt, segment1b.ipt, segment1c.ipt, segment2.iam]
2014-10-20 3D modeling
    [arm.iam, arm_bom.xls, elektronika.ipt, stand.iam, stand_plate1.ipt, stand_plate2.ipt, stand_plate3.ipt, stand_plate4.ipt]
2014-10-22 Rename and generate production files
    [plywood_3.7mm.idw, plywood_4mm.dwg, plywood_4mm.dxf, plywood_4mm.idw, plywood_5mm.idw, plywood_6mm.dwg, plywood_6mm.dxf, plywood_6mm.idw]
2015-08-27 Nowa PCB - wersja robocza
    [drOctopus.kicad_pcb, drOctopus.sch]
2015-08-31 Working on new PCB
    [drOctopus.kicad_pcb, drOctopus.sch]
2015-09-01 PCB ready to be sent
    [drOctopus-B_Cu.gbl, drOctopus-B_Mask.gbs, drOctopus-B_SilkS.gbo, drOctopus-Edge_Cuts.gm1, drOctopus-F_Cu.gtl, drOctopus-F_Mask.gts, drOctopus-F_SilkS.gto, drOctopus.drl]
2015-11-10 Last commit for this version
    [drOctopus.sch]
2015-11-10 First test software for MQTT for Python (Spyder) and Arduino (Eclipse).
2015-11-12 Beginning of main Arduino software
2015-11-24 Add servos
2015-11-27 Change some net names
    [drOctopus.kicad_pcb]
2015-11-29 Improve servos driver
2015-12-13 Added usage of program memory for strings. Global variables size reduction: - Without debug: 1520 -> 1383 (program 21348 -> 21490) - With debug, hardware uart: 1642 -> 1401 (program 22040 -> 22294)
2015-12-20 Add SPI debug mode
2016-01-23 Base of ne PCB design - two PCBs
    [drOctopus-B_Cu.gbl, drOctopus-B_Mask.gbs, drOctopus-B_SilkS.gbo, drOctopus-Edge_Cuts.gko, drOctopus-F_Cu.gtl, drOctopus-F_Mask.gts, drOctopus-F_SilkS.gto, drOctopus.drl]
2016-01-23 Clean and rename
    [drOctopus-B_Cu.gbl, drOctopus-B_Mask.gbs, drOctopus-B_SilkS.gbo, drOctopus-Edge_Cuts.gko, drOctopus-F_Cu.gtl, drOctopus-F_Mask.gts, drOctopus-F_SilkS.gto, drOctopus.drl]
2016-01-24 Working on Power PCB
    [drOctopusPower.kicad_pcb, drOctopusPower.sch, drOctopusPower.xls]
2016-01-28 Working on PCBs
    [calculations.xls, drOctopusControl.kicad_pcb, drOctopusControl.sch, drOctopusControl.xls, drOctopusPower.kicad_pcb, drOctopusPower.sch]
2016-01-28 Schematic polishing
    [drOctopusControl.sch]
2016-02-01 PCB routing
    [drOctopusControl.kicad_pcb, drOctopusControl.sch]
2016-02-04 Probably final version of PCBs
    [calculations.xls, drOctopusControl.kicad_pcb, drOctopusControl.sch, drOctopusPower.kicad_pcb, drOctopusPower.sch]
2016-02-04 Little fix of silkscreen
    [drOctopusControl.kicad_pcb]
2016-02-04 Last corrections. Gerber generation.
    [_saved_drOctopusControl.sch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]
2016-02-04 Mechanical parts added
    [_saved_drOctopusControl.sch, drOctopusControl.sch, drOctopusPower.kicad_pcb]
2016-02-06 Remove old version of controller firmware (Arduino). Add new blank project for new version of controller firmware (STM32 using System Workbench for STM32).
2016-02-06 Remove old version of controller firmware (Arduino). Add new blank test project for STM32.
2016-02-08 Add basic outputs module with LED driver
2016-02-08 Basic DMA configuration for debug UART.
2016-02-09 debugPrint function with DMA and printf-like formatting.
2016-02-11 Add PWM driver. Refactor peripheral clock setup functions.
    [calculations.xls]
2016-02-13 Add servo driver. Refactor uint_8_t -> uint_fast8_t as output code in some functions.
2016-02-14 Working on servo driver.
2016-02-14 Add interrupt handlers to vector table.
2016-02-14 Add interrupt handler to vector table.
2016-02-15 Update servo driver. Add speed control.
2016-02-15 Simple ADC driver.
2016-02-16 ADC with DMA transfer.
2016-02-16 Configure ADC to convert on PWM_TIMER update.
2016-02-19 Add HW0 pinout to Excel sheet.
    [calculations.xls]
2016-02-19 Add simple I2C init.
2016-02-21 Rename sysTick.c ->delay.c. Add delayUs function, using standard timer. Add DELAY_TEST build configuration with test for delay functions.
2016-02-21 Optimize delayUs function. Led pulse length for delayUs(1): 3.98us -> 3.32us
2016-02-21 Optimize delayUs test function. Led pulse length for delayUs(1): 3.32us -> 2.96us.
2016-02-21 Optimize delayUs test function. Led pulse length for delayUs(1): 2.96us -> 2.70us.
2016-02-21 Optimize delayUs test function. Led pulse length for delayUs(1): 2.70us -> 2.50us.
2016-02-21 Fix delayUs function. Led pulse length for delayUs(1): 2.50us -> 1.53us.
    [delay.c]
2016-02-22 Update pinout calculations.
    [calculations.xls]
2016-02-22 Remove unneeded file.
    [calculations.xls]
2016-02-27 New timer functions.
2016-02-27 Add LEDs to pinout HW0.
    [calculations.xls]
2016-02-27 Move design files.
    [BOM.xls, calculations.xls, design.xls, working area.ipt, working area.stp]
2016-02-27 Simple I2C driver: transmit.
2016-02-27 Debug: wait until previous print is complete. Add debug test build configuration.
2016-02-28 Working on I2C driver. Dead end, will be corrected.
    [i2c.c, i2c.h]
2016-02-28 I2C driver cleanup.
2016-02-29 Simple software I2C driver instead of shitty STM32 hardware one.
2016-02-29 Oled driver.
2016-03-13 Add BOM.
    [DrOctopus2.0_BOM.xls, drOctopusControl_BOM.csv, drOctopusPower_BOM.csv]
2016-03-13 Change annotations on schematic.
    [drOctopusControl.sch]
2016-03-13 Pinout for uC change in HW1 (STM32F030RCT6).
    [calculations.xls]
2016-03-13 Start writing ESP8266 driver.
2016-03-20 Work on redesigning ElClient library.
    [ESP8266.cpp, main.c]
2016-03-21 Building ESP8266 driver.
2016-03-21 Working ESP8266 MQTT driver.
2016-03-22 Move project to HW1 platform.
    [STM32F030RCT.cfg]
2016-04-02 Cosmetic fix (preprocessor syntax and error message).
    [pinoutHw0.h, pinoutHw1.h]
2016-04-02 Little fix of delay test. Add comments. Delay test working for HW1.
    [delay.c]
2016-04-02 Lower PWM frequency to 200Hz - higher not necessary.
2016-04-02 Add outputs test. Fix PWM initialization. Outputs test working for HW1.
    [outputs.c]
2016-04-03 Add debugPrintRaw function to print debug without prefix and newline.
2016-04-03 Fix PWM IRQ configuration.
    [outputs.c]
2016-04-03 Fix ADC configuration. Add ADC test firmware. Test working with HW1.
    [adc.c, pinoutHw0.c, pinoutHw1.c]
2016-04-03 Little fix of TEST_MODE selection #if command.
    [ESP8266.cpp, i2c.c, oled.c]
2016-04-04 Add Default_Handler and HardFault_Handler with blinking leds.
2016-04-04 Fix some implicit conversion warnings.
    [adc.c, adc.h, debug.c, outputs.c, servo.c]
2016-04-04 Pinout update.
    [calculations.xls]
2016-04-04 Cosmetic changes of annotations to improve readability.
    [drOctopusControl.kicad_pcb]
2016-04-04 Working on ESP8266 driver on HW1. Fix some implicit conversion compiler warnings (and some real errors too). Add programming mode - pipe between ESP USART and debug USART.
    [ESP8266.cpp, espStream.cpp, espStream.h, espUsartRxBuffer.cpp, oled.c, pinoutHw1.h]
2016-04-04 Fix some implicit conversion and unused parameter warnings.
    [delay.c, i2c.c]
